Zichuan-ALT/vibration-monitor/evidence/setup_overview.jpg

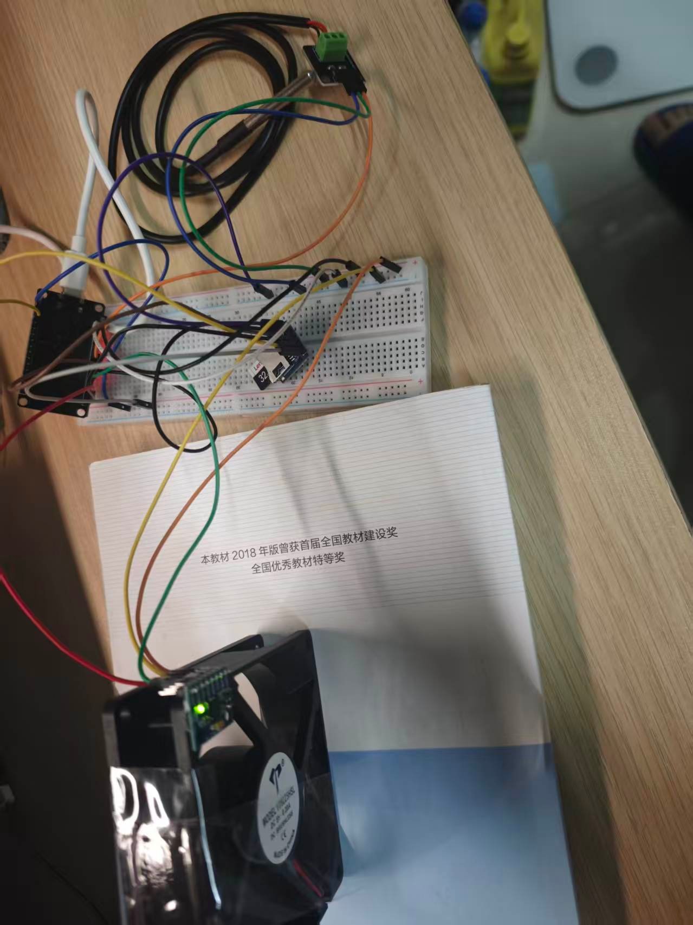
evidence/setup_overview.jpg
