Zichuan-ALT/vibration-monitor/evidence/wiring_breadboard.jpg

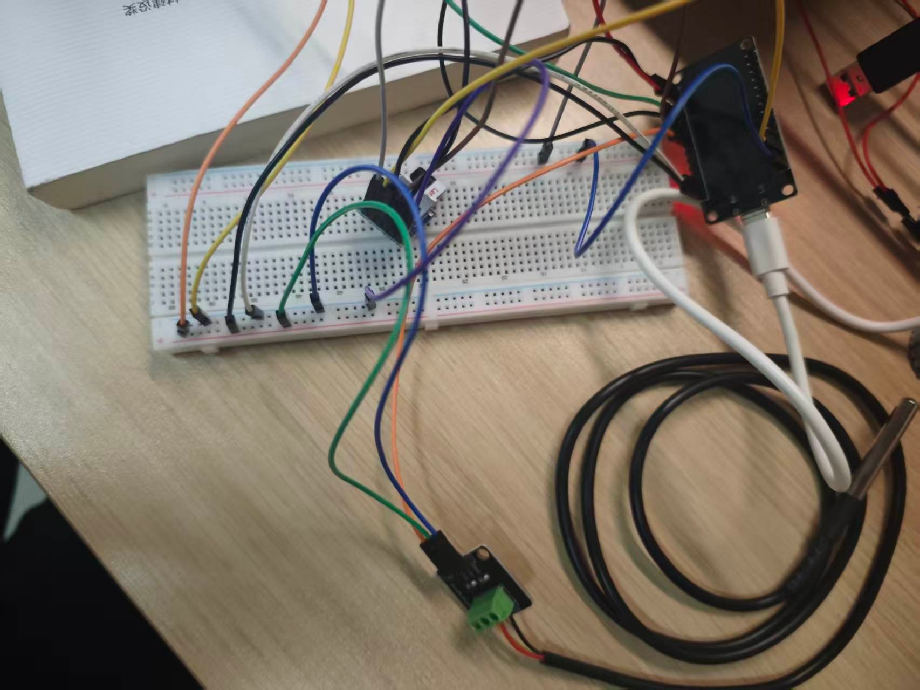
evidence/wiring_breadboard.jpg
