Zichuan-ALT/vibration-monitor/8.1_报告大纲.md

# 8.1 振动状态监测器 —— 工程报告大纲

> 目标篇幅：正文约 28~32 页（不含附录）
> 材料来源均已在仓库中，标注于各节末尾

---

## 1. 引言（约 2 页）

### 1.1 背景与问题
- 旋转机械（风机、水泵、电机）的失效大部分由不平衡、轴承磨损、松动引起
- 传统做法是定期人工巡检或事后维修，成本高、发现晚
- 状态监测（Condition Monitoring）的价值：在故障早期发现征兆

### 1.2 项目目标
- 用低成本器件（≤ ¥150）实现一台可运行、可复现的振动状态监测样机
- 要求：多传感、边缘处理、联网上报、可视化与报警建议

### 1.3 报告结构
- 简述各章内容

---

## 2. 需求分析（约 3 页）

### 2.1 利益相关者与使用场景
- 校园设施运维人员（真实使用者）
- 教学演示（LICHPU 学生）
- 场景：小型风机/水泵的日常状态监测

### 2.2 功能需求（11 条）
- 表格：编号 / 需求 / 优先级（Must / Should / Could）
- **材料**：`8.1_振动状态监测器_项目提案与需求规格说明.docx` 表 5

### 2.3 非功能需求（9 条）
- 重点强调：**成本 ≤ ¥150**、**零焊接**、可用性、可维护性
- **材料**：提案 表 6

### 2.4 验收标准与验证方法（13 条）
- 表格：编号 / 验收标准 / 验证方法 / 实测结果
- **材料**：提案 表 7；实测结果见 `实施方案` 表 27~29

### 2.5 约束与假设
- 单相 220 V 供电、2.4 GHz Wi-Fi、演示用小型风机
- 不涉及高温、高压、防爆场景

---

## 3. 方案设计与选型（约 5 页）

### 3.1 总体架构
- 三层：传感层 → 边缘层 → 服务层
- 架构图（`figures/` 中已有）
- **关键点**：所有特征提取与状态判定都在边缘完成，不上传原始波形

### 3.2 关键设计决策（每个决策都要有"备选方案 → 选择理由"）

| 决策点 | 备选 | 本方案选择 | 理由 |
|---|---|---|---|
| 振动传感器 | 压电式 / ADXL345 / MPU6050 | **MPU6050** | 成本低、I²C 简单、已焊针、±4 g 够用 |
| 温度传感器 | DS18B20 / NTC / 热电偶 | **DS18B20** | 数字输出免标定、单总线、防水探头 |
| 计算位置 | 云端 / 边缘 | **边缘** | 带宽、延迟、隐私、离线可用 |
| 传输协议 | HTTP / MQTT | **MQTT** | 轻量、发布订阅、QoS |
| 存储 | 云数据库 / SQLite | **SQLite** | 零配置、本地、够用 |
| 可视化 | 自研前端 / Node-RED | **Node-RED** | 快速搭建、仪表板开箱即用 |

### 3.3 信号处理设计（**技术核心，要写透**）

**① 采样参数推导**
- 目标分析带宽 → 采样率：关注 10~260 Hz，按 Nyquist 至少 520 Hz，取 **1 kHz** 留余量
- 频率分辨率：Δf = fs/N，取 N=1024 → **Δf = 0.977 Hz**
- 帧长：1024/1000 = **1.024 s**，兼顾实时性与分辨率
- 量程：±4 g（8192 LSB/g），兼顾分辨率与不平衡工况的峰值

**② 为什么必须"带限"计算 RMS**
- 全带 RMS 会把 <10 Hz 的桌面晃动、手持抖动算进去
- 实测对比：全带 RMS 0.05 g vs 带限 RMS 0.005 g（相差 10 倍）
- 实现：由单边幅度谱按 Parseval 定理求 Σ A_k²/2

**③ 特征量选择**
- 带内 RMS：整体振动能量
- 基频带峰值（20~45 Hz）：1× 转频分量，对不平衡最敏感
- 速度有效值（10~250 Hz 积分）：对应 ISO 10816 的评价量

**④ 基线自学习与迟滞判定**
- μ、σ 由 15 帧自学习得到；阈值 = μ+3σ / μ+6σ
- 迟滞：升级 3 帧确认、降级 5 帧确认，避免抖动
- **基线下限保护**：μ < 0.010 g 时拒绝基线（防止停机状态学习）

### 3.4 硬件设计
- 引脚分配表（`实施方案` 表 8）
- 供电：3V3 给传感器、5V 给风扇与 SD 卡
- **零焊接实现**：全部选用已焊针模块 + 面包板 + 杜邦线

### 3.5 软件设计
- 固件流程（启动 → 自学习 → 循环测量 → 缓冲 → 上报）
- Node-RED 流程（MQTT in → 拆分 → 仪表板 / SQLite / 状态映射）
- 数据模型（JSON 字段说明 + SQLite 表结构）

---

## 4. 实现（约 4 页）

### 4.1 硬件搭建
- 13 个搭建步骤的要点（`实施方案` 第 5 章）
- **实际遇到的问题**：模块未焊针、面包板孔被压住、杜邦线松动

### 4.2 固件实现
- 关键代码片段：采样定时、FFT、带限 RMS、环形缓冲、NTP
- **库版本差异**：arduinoFFT 2.x 的模板类与 API 变化

### 4.3 服务端实现
- Node-RED 流程截图
- SQLite 表结构与写入方式（必须用 `prepared`）

### 4.4 仪表板实现
- 实时状态页 / 历史查询页
- 双通道显示（振动 + 表面温度）

### 4.5 成本控制
- 实际支出 ¥119.50 / 预算 ¥150 / 结余 ¥30.50
- **材料**：`实施方案` 表 3~7

---

## 5. 测试与验证（约 5 页）

### 5.1 测试策略
- 单元测试（传感器自检）/ 集成测试（端到端）/ 系统测试（工况实验）

### 5.2 传感器标定与验证

| 项目 | 方法 | 结果 |
|---|---|---|
| MPU6050 真伪 | 读 WHO_AM_I 原始寄存器 | 0x68（原厂） |
| 重力模长 | 静止读取 | 0.991~1.002 g（偏差 0.9%） |
| 噪声底 | 1024 点 × 多帧 | 0.0053 g（带限） |
| DS18B20 稳定性 | 静置 90 s | 噪声 < 1 LSB |
| DS18B20 响应 | 手指捏 30 s | +3.25 ℃，τ≈25~30 s |
| DS18B20 恢复 | 松手 100 s | −4.50 ℃，无迟滞 |

### 5.3 采样与 FFT 验证
- 实测 fs = 999.7 Hz，误差 **−0.03%**（判据 ≤0.5%）
- 谱线锐利无裙边 → 定时与窗函数正确

### 5.4 不平衡工况实验
- 三组：0 / 0.35 / 0.70 g 蓝丁胶配重（单片扇叶、35 mm 半径）
- 结果表 + 频谱对比图
- **材料**：`experiments/2026-10-26-不平衡工况.md`，`experiments/data/spectra_compare.png`

### 5.5 频谱分析
- 1× 33.2 Hz，谐波 3×/4×/7× 同步抬升 → 不平衡的典型特征
- **由 232 Hz 叶片通过频率反推叶片数 = 7**（交叉验证）
- 动态范围约 40 dB

### 5.6 系统联调
- 端到端链路验证
- store-and-forward：断网 30 s，缓冲 5 条，恢复后全部补发
- 补发数据时间戳落在原始测量时刻（NTP 保证）
- **材料**：`experiments/2026-10-26-系统联调.md`

### 5.7 验收标准符合性矩阵
- **13 条 AC 逐条对照实测结果**，这是评估"目标达成"的直接证据

---

## 6. 数据分析与讨论（约 4 页，**最能拉开差距的一章**）

### 6.1 检测灵敏度
- 0.35 g 配重（转子质量 0.4%）→ RMS 上升 25.7 倍
- 结论：方案灵敏度远超需求

### 6.2 亚线性响应与共振
- 配重加倍只带来 1.8 倍增幅（非 2 倍）
- 理论校核：不平衡力 F = m·r·ω²，实测放大 Q≈3.7 → 接近系统共振

### 6.3 **支撑刚度的影响（本项目最有价值的实测发现）**
- 同一台风扇、同一转速，RMS 出现 0.055 g 与 0.207 g（**差 3.7 倍**）
- 判别指标：**基频峰值 / 带内 RMS**
  - 固定良好 ≈ 1.0；风扇晃动 = 0.36
- **认识论层面的教训**：按压传感器时同时给整体结构加阻尼，两个变量混淆，
  导致第一次判断错误；改为按压风扇底座才定位到真因
- 工业含义：传感器无法区分"结构振动"与"刚体运动"，故标准要求刚性基础

### 6.4 温度通道的时间常数与报警设计
- τ ≈ 25~30 s → 温度报警须设分钟级确认延时
- 与振动通道（秒级）的延时策略不同

### 6.5 阈值确定方法
- 固定阈值 vs 基线自学习
- 实测：μ+3σ / μ+6σ 能清晰区分三种工况
- 自学习的脆弱点与保护措施

### 6.6 与设计预期的偏差
| 项目 | 设计预期 | 实测 | 偏差原因 |
|---|---|---|---|
| 噪声底 | 0.0005~0.001 g | 0.0053 g | 估算未计入 DLPF 带宽 |
| 风扇转频 | 1700 RPM | 2050~2120 RPM | 铭牌不准 |
| 基频带 | 15~35 Hz | 需放宽到 20~45 Hz | 实测转速超出 |

### 6.7 局限性
- 单一测点、单轴（虽三轴但取最强）
- 无转速传感器，靠频谱推断
- 未做长时间误报率统计
- 演示用小型风机对配重过于敏感，与工业机组可比性有限

---

## 7. 专业实践（约 2 页）

### 7.1 版本控制
- Git 仓库 70 个文件、15+ 次提交、语义化提交信息
- 仓库地址：https://github.com/Zichuan-ALT/vibration-monitor

### 7.2 风险管理
- 13 项风险登记册（提案 表 11）
- **实际发生的风险**：模块未焊针、网络屏蔽 GitHub、传感器松动

### 7.3 受控文档
- 台账 9 张表：需求追踪、BOM、测试记录、工况记录、问题日志、变更记录、会议记录、风险登记、交付清单

### 7.4 调试记录（体现工程能力）
三个典型问题的排查过程：
1. `Bad data inject` → 读源码定位 payload 结构要求
2. 历史图空白 → 对比同项目正常节点，发现 `removeOlder = 0` 陷阱
3. 振动读数异常偏高 → 排除法定位到支撑刚度

### 7.5 标准与规范
- ISO 10816（振动烈度评价）
- DS18B20 / MPU6050 数据手册
- MQTT 3.1.1

---

## 8. 负责任的设计（约 2 页）

### 8.1 安全
- 电气：3.3 V 逻辑、USB 供电、无市电裸露
- 机械：风扇固定、配重防甩飞（离心力计算）
- 数据：本地存储、不上传原始波形

### 8.2 隐私
- 仅采集设备振动与温度，不涉及人员信息
- 无摄像头、无音频

### 8.3 可持续性
- 成本 ¥119.50，可批量部署
- 低功耗（ESP32 + 传感器约 0.5 W）
- 模块化设计，损坏可单独更换

### 8.4 可维护性
- 串口命令 `r` 重学基线、`b` 查状态
- 阈值自适应，无需人工设定
- 断网可用（store-and-forward）

### 8.5 伦理与社会影响
- 正面：减少非计划停机、延长设备寿命
- 风险：过度依赖自动化报警、需保留人工判断

---

## 9. UL–LICHPU 复制与推广（约 1 页）

### 9.1 环境差异
| 项目 | UL（爱尔兰） | LICHPU（中国） |
|---|---|---|
| 供电 | 230 V / 50 Hz | 220 V / 50 Hz |
| 网络 | 校园 Wi-Fi（802.1X） | 热点/有线 |
| 采购 | 欧盟渠道 | 国内电商 |

### 9.2 复制需要做的适配
- 电源插头与电压（本方案用 USB 5 V，天然兼容）
- Wi-Fi 认证方式（需改为企业级认证或热点）
- 元器件替代（同型号国内可得）

### 9.3 价值
- 教学：低成本、可拆解、现象直观
- 运维：可作为校园设施的轻量监测节点

---

## 10. 结论与后续工作（约 1.5 页）

### 10.1 完成情况
- 对照 13 条验收标准，全部达成
- 可运行样机、双通道数据、完整链路

### 10.2 主要贡献
1. 在 ¥150 预算内实现完整状态监测链路
2. 实测量化了支撑刚度对测量的影响（3.7 倍）
3. 建立了可复现的实验方法与证据链

### 10.3 后续改进
- 加转速传感器，实现阶次分析
- 多测点、多设备组网
- 引入机器学习做故障分类
- 长时间运行统计误报率

---

## 附录

| 附录 | 内容 | 来源 |
|---|---|---|
| A | 硬件清单与实际成本 | 实施方案 表 3~7 |
| B | 引脚分配表 | 实施方案 表 8 |
| C | 固件关键参数表 | 实施方案 表 23 |
| D | 关键代码清单 | `firmware/` |
| E | 实验原始数据 | `experiments/` |
| F | 仪表板与频谱截图 | `evidence/`、`experiments/data/` |
| G | 团队分工与个人贡献 | 待补 |
| H | 参考文献 | 待补 |

---

## 写作建议

### 优先级（若时间紧）
1. **第 5、6 章**（测试与数据分析，占 20%，且我们素材最全）
2. **第 3 章**（技术设计，占 25%）
3. 第 2、7、8 章（可从已有文档摘取）
4. 第 1、9、10 章（最后写，收尾性质）

### 写作顺序建议
```
先写第 5 章（有数据，最好写）
→ 再写第 6 章（基于第 5 章的分析）
→ 再写第 3 章（技术设计，需回头对照）
→ 最后补 1/2/7/8/9/10 章
→ 摘要最后写
```

### 可以直接复用的内容
- 第 2 章 ← 提案（17 页）几乎可直接摘
- 第 3、4 章 ← 实施方案（25 页）改写
- 第 5 章 ← 3 份实验记录组装
- 第 7 章 ← 台账

### 图表清单（需要在报告中出现的）
| 图号 | 内容 | 文件 |
|---|---|---|
| 图 1 | 系统架构图 | `figures/` |
| 图 2 | 硬件接线图 | 实施方案 图 8 |
| 图 3 | 固件流程图 | 实施方案 |
| 图 4 | 三工况频谱对比 | `experiments/data/spectra_compare.png` |
| 图 5 | 仪表板-正常 | `evidence/dashboard_live_normal.png` |
| 图 6 | 仪表板-报警 | `evidence/dashboard_live_alarm.png` |
| 图 7 | 仪表板-双通道 | `evidence/dashboard_dual_sensor.png` |
| 图 8 | 历史曲线 | `experiments/data/history_from_db.png` |
| 图 9 | 温度响应曲线 | 由实验记录数据重绘 |
