Zichuan-ALT/vibration-monitor/evidence/dashboard_alarm.png

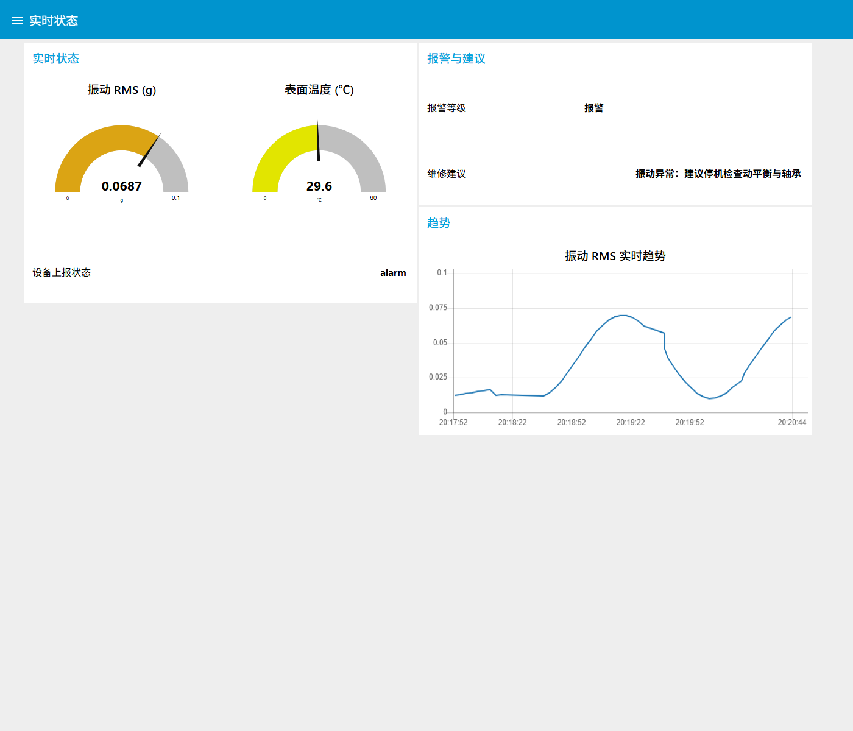
evidence/dashboard_alarm.png
