Zichuan-ALT/vibration-monitor/evidence/dashboard_dual_sensor.png

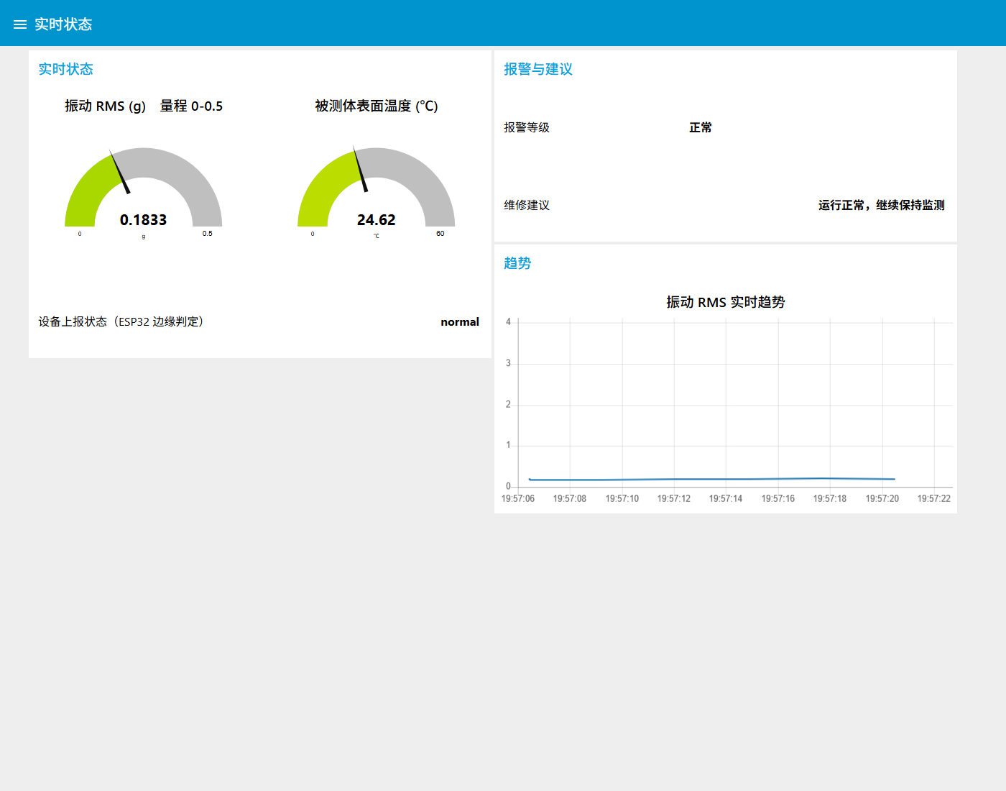
evidence/dashboard_dual_sensor.png
