Zichuan-ALT/vibration-monitor/evidence/dashboard_live_v1.png

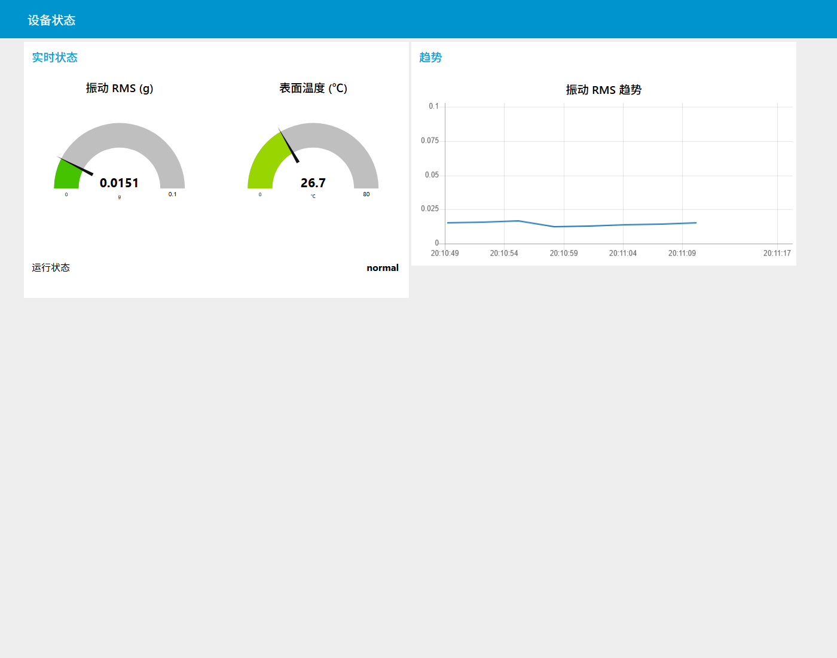
evidence/dashboard_live_v1.png
