Zichuan-ALT/vibration-monitor/evidence/dashboard_live_v2.png

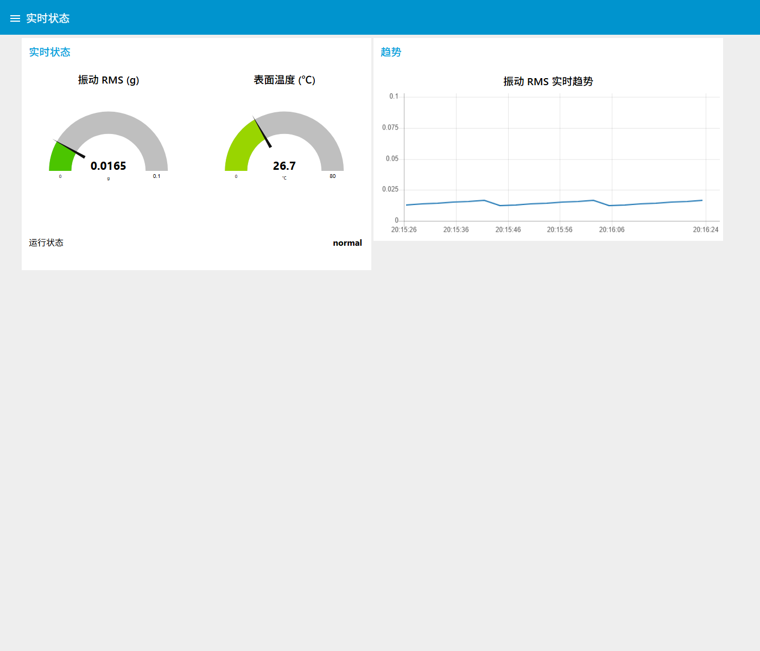
evidence/dashboard_live_v2.png
