Zichuan-ALT/vibration-monitor/evidence/device_with_dashboard.jpg

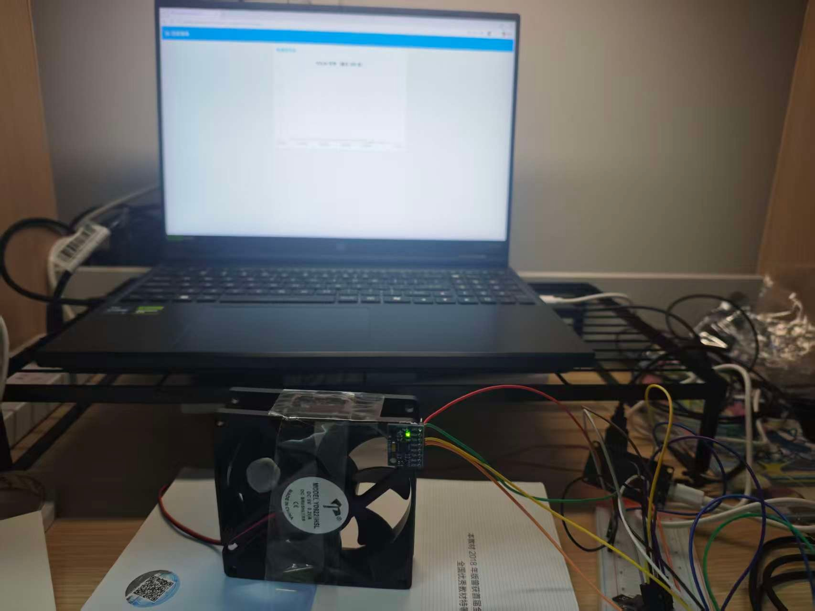
evidence/device_with_dashboard.jpg
