Zichuan-ALT/vibration-monitor/experiments/data/spectrum_工况1-基准_0g_.png

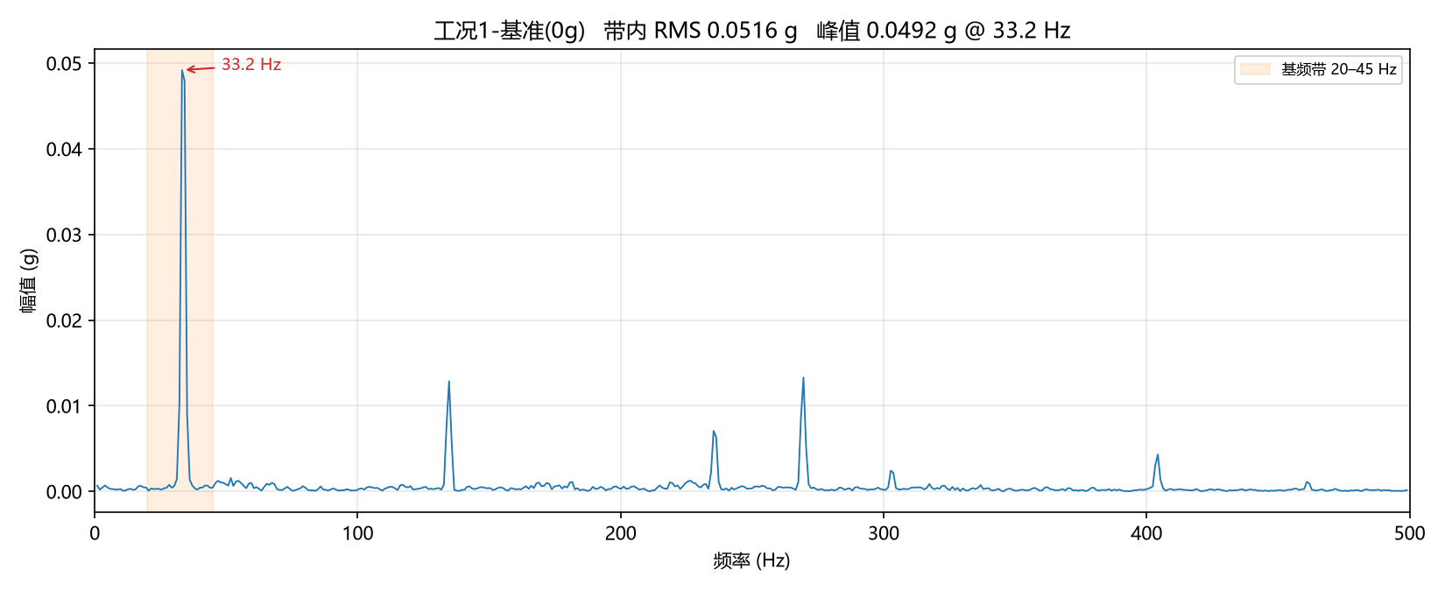
experiments/data/spectrum_工况1-基准_0g_.png
