Zichuan-ALT/vibration-monitor/experiments/data/spectrum_工况2-轻微不平衡_0_35g_.png

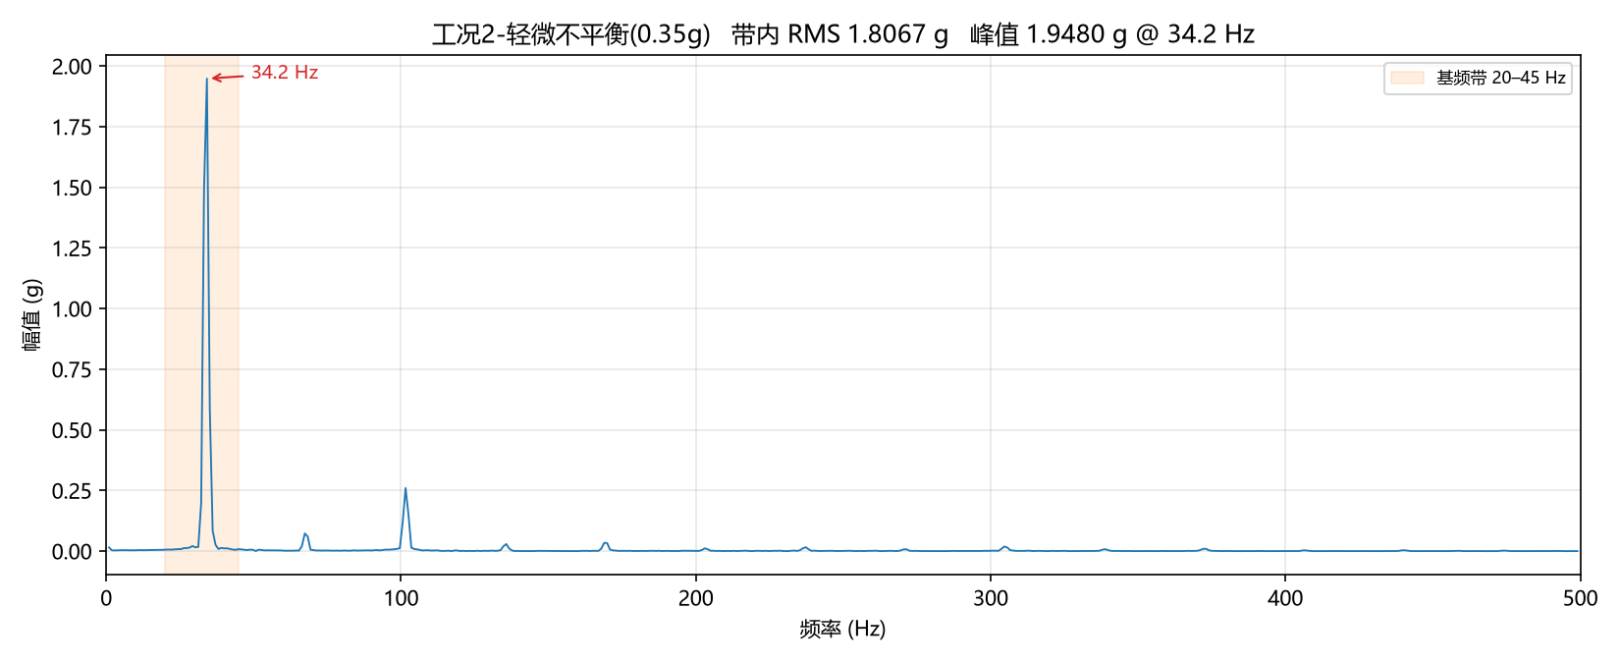
experiments/data/spectrum_工况2-轻微不平衡_0_35g_.png
