Zichuan-ALT/vibration-monitor/experiments/data/spectrum_工况3-明显不平衡_0_70g_.png

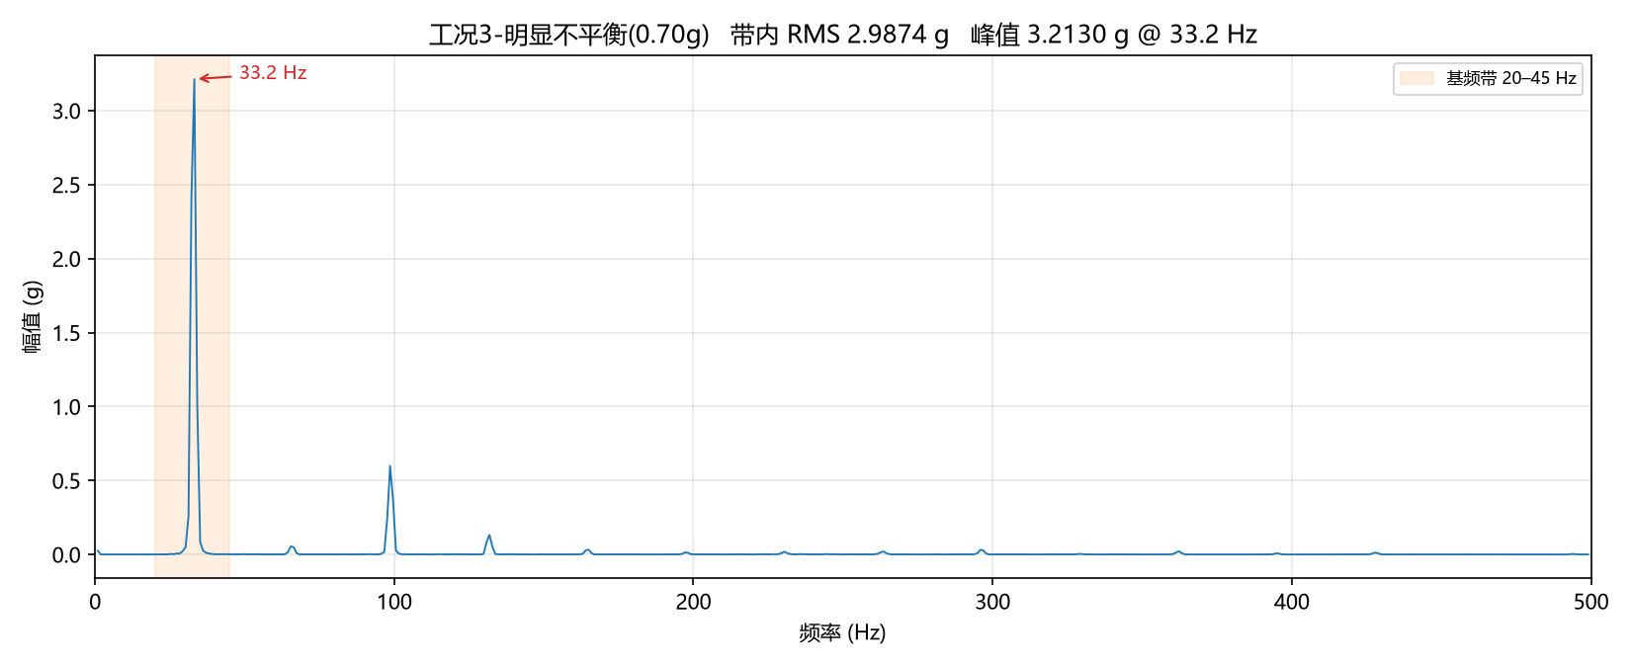
experiments/data/spectrum_工况3-明显不平衡_0_70g_.png
