Zichuan-ALT/vibration-monitor/8.1_受控文档台账.xlsx

Sheet: 0-文档控制
项目 8.1 振动状态监测器 · 受控文档台账
利莫瑞克大学 × LICHPU 工业评估（15 ECTS）· 智慧校园生活实验室 · 主题 8 智能设施与预测性维护
文件名 | 8.1_受控文档台账.xlsx
版本 | V3.2
更新日期 | 2026-10-29
技术路线 | ESP32-WROOM-32 单板 + MPU6050（I²C，加速度 + 板载温度）+ DS18B20 表面温度 + Node-RED 仪表板
装配方式 | 模块均为带排针的成品板，杜邦线直插；裸线经螺丝端子转接，无需额外加工
对应关口 | 第 2 周 需求关口 / 第 3 周 设计关口 / 第 6 周 中期评估
关联主文档 | 8.1_振动状态监测器_项目提案与需求规格说明.docx（提案与需求，评估组成 A） 8.1_振动状态监测器_实施方案.docx（施工、调试与验证手册）
维护责任人 | P1 项目/客户协调员（风险登记册与计划）；P4 测试/验证（测试记录）
变更规则 | 任一工作表的字段增删须在“8-变更记录”中登记，并由 P1 更新版本号
评审节奏 | 每周例会复核一次；关口前 2 天冻结并导出 PDF 归档
成本口径 | 物料清单按「参考价 / 实际采购价」双列登记，实际采购支出合计 ¥119.50，详见「2-物料与耗材清单」
工作表一览
1-需求与验收 | 11 项功能性需求、9 项非功能性需求、13 条验收标准及追溯关系
2-物料与耗材清单 | 13 项物料，含分类小计与实际支出合计（公式自动计算）
3-风险登记册 | 12 项风险，等级由概率 × 影响自动计算
4-责任矩阵 | 9 项交付物 × 4 个角色的 R/S/C/I 分工
5-十二周计划 | 任务、周次、责任人、交付物与正式关口
6-测试记录 | 测试执行记录模板（对应评估组成 D）
7-工况实验记录 | 工况变化对照实验的数据记录模板
8-变更记录 | 受控文档的版本变更登记

Sheet: 1-需求与验收
需求与验收标准（含追溯关系）
项目 8.1 振动状态监测器 · 受控文档台账 | 版本 V3.2 | 更新日期 2026-10-29 | 维护人：P1
编号 | 类别 | 需求 / 判据描述 | 优先级 | 追溯对象 | 验证方法 | 证据周次
FR-01 | 功能 | 采集振动（I²C，1 kSPS，帧长 1024 点）与两路温度，共三路数据 | M | AC-01 / AC-04 | 单元 + 集成 | 第 4 周
FR-02 | 功能 | 计算时域特征：RMS、峰值、速度有效值（10 ~ 250 Hz 积分） | M | AC-03 | 单元 | 第 5 周
FR-03 | 功能 | 完成 1024 点 FFT，给出主频与基频带（15 ~ 35 Hz）内峰值 | M | AC-02 | 单元 | 第 5 周
FR-04 | 功能 | 支持开机基线自学习，并给出相对基线的偏离度 | M | AC-05 / AC-06 | 系统 | 第 6 周
FR-05 | 功能 | 输出“正常 / 注意 / 报警”三级状态与维护建议 | M | AC-05 / AC-06 | 系统 + 验证实验 | 第 8 周
FR-06 | 功能 | 通过 MQTT 上报特征值，周期 ≤ 10 s，事件即时上报 | M | AC-07 | 集成 | 第 6 周
FR-07 | 功能 | 断网时本地缓存，网络恢复后补传，不丢数据 | S | AC-09 | 系统 | 第 10 周
FR-08 | 功能 | 提供中英双语仪表板，含实时值、历史趋势与频谱 | M | AC-10 | 用户评估 | 第 6 周
FR-09 | 功能 | 提供本地指示（板载 LED + 蜂鸣器），无网络时仍可判读 | S | AC-09 | 系统 | 第 10 周
FR-10 | 功能 | 记录报警事件（含触发指标与时间戳）并可导出 | S | AC-10 | 系统 | 第 9 周
FR-11 | 功能 | 支持板载按键重新学习基线与静音 | C | — | 现场操作 | 第 10 周
NFR-01 | 非功能 | 全部电路 ≤ 5 V 直流（USB 供电），不接触市电；转动部件加防护 | M | — | 走查 | 第 3 周
NFR-02 | 非功能 | 不使用摄像头或麦克风，不采集任何可识别个人的数据 | M | — | 走查 | 第 3 周
NFR-03 | 非功能 | 连续运行 ≥ 72 h 无重启；看门狗、掉电恢复、断网自愈 | M | AC-08 | 系统 | 第 10 周
NFR-04 | 非功能 | 模块可现场插拔更换且免重新编译；基线可一键重学 | S | — | 走查 | 第 10 周
NFR-05 | 非功能 | 单节点成本 ≤ ¥150（含耗材与备件） | M | AC-11 | 核算 | 第 3 周
NFR-06 | 非功能 | 仪表板中英双语；状态用文字 + 图标 + 颜色三重编码；字号可调 | M | — | 用户评估 | 第 6 周
NFR-07 | 非功能 | 数据模型带版本号并有文档，可被第三方平台订阅复用 | S | — | 走查 | 第 9 周
NFR-08 | 非功能 | 全程使用杜邦线与螺丝端子转接 | M | AC-13 | 走查 | 第 3 周
NFR-09 | 非功能 | 外壳防护 ≥ IP54，工作温度 0 ~ 50 ℃ | S | — | 走查 | 第 10 周
AC-01 | 验收 | 振动采样率误差 ≤ 0.5 % | — | FR-01 | 连续采集 1 s 统计实际点数（1000 ± 5） | 第 4 周
AC-02 | 验收 | 频谱频率误差 ≤ 1 % 或 ≤ Δf | — | FR-03 | 音箱振膜 + 100 Hz 正弦验证 | 第 5 周
AC-03 | 验收 | 幅值相对偏差 ≤ 10 % | — | FR-02 | 与手持测振仪同点同时比对 | 第 7 周
AC-04 | 验收 | 温度测量准确度 ± 0.5 ℃ | — | FR-01 | 冰水浴与温水比对 | 第 5 周
AC-05 | 验收 | 3 类工况变化中至少 2 类在 60 s 内检出并分级正确 | — | FR-05 | 不平衡 / 松动 / 负载变化对照实验 | 第 8 周
AC-06 | 验收 | 正常工况 2 h 内假阳性 ≤ 1 次 | — | FR-04 | 正常工况长时运行 | 第 8 周
AC-07 | 验收 | 报警端到端延迟 ≤ 5 s | — | FR-06 | 注入越限信号并计时 | 第 8 周
AC-08 | 验收 | 连续运行 ≥ 72 h 无重启，丢数率 ≤ 1 % | — | NFR-03 | 不间断运行并统计记录条数 | 第 10 周
AC-09 | 验收 | 断网 ≤ 30 s 内自动重连并补传 | — | FR-07 / FR-09 | 拔插网线测试 | 第 10 周
AC-10 | 验收 | 仪表板刷新 ≤ 5 s；历史可查 ≥ 4 周 | — | FR-08 / FR-10 | 走查 + 数据库查询 | 第 9 周
AC-11 | 验收 | 单节点成本 ≤ ¥150 | — | NFR-05 | 按物料清单核算（本版 ¥94 / ¥119） | 第 3 周
AC-12 | 验收 | 重复性：变异系数 ≤ 3 % | — | FR-02 / FR-03 | 同一工况重复测量 10 次 | 第 8 周
AC-13 | 验收 | 装配方式：全部连接为插拔式或螺丝端子 | — | NFR-08 | 装配过程走查与记录 | 第 3 周
优先级：M 必须 / S 应该 / C 可以。验收标准均须附测量记录，证据归档到 Git 仓库 /evidence 目录。

Sheet: 2-物料与耗材清单
物料与耗材清单（参考价 / 实际采购价对照）
项目 8.1 振动状态监测器 · 受控文档台账 | 版本 V3.2 | 更新日期 2026-10-29 | 维护人：P1
# | 类别 | 物料 / 规格 | 数量 | 参考单价 ¥ | 实际单价 ¥ | 实际小计 ¥ | 采购备注
1 | 主要器件 | ESP32-WROOM-32 开发板（CH340C，带排针 30Pin，Type-C） | 2 | 25 | 23 |  | 含备件；淘宝
2 | 主要器件 | MPU-6050 三轴重力加速度模块（GY-521，带排针，I²C） | 1 | 6 | 13.5 |  | 到货读 WHO_AM_I 应为 0x68
3 | 主要器件 | DS18B20 带防水探头转接模块 + 传感器 + 杜邦线 | 1 | 8 | 8.5 |  | 模块自带绿色端子
4 | 主要器件 | Micro SD 卡模块 SPI 接口（带排针，带电平转换） | 1 | 5 | 2.3 |  | VCC 先试 3.3 V，不行再 5 V
5 | 主要器件 | microSD 32 GB Class10 A1（联想，全新带 5 年换新） | 1 | 15 | 35.9 |  | 不用二手卡；到手拷 4 GB 验容量
6 | 主要器件 | 有源蜂鸣器模块（3.3~5 V，低电平触发） | 1 | 2 | 1.5 |  | 低电平触发：GPIO25 输出 LOW 时响；上电前先拉高，见实施方案 5.3 ⑤
7 | 主要器件 | 静音风扇 5 V 9225（92 mm，1700 RPM，XH2.54-2P） | 1 | 12 | 4.8 |  | 转频 28.3 Hz，落在基频带内
8 | 连接件 | TYPE-C 数据线 1 m（可传输数据） | 1 | 5 | 2.2 |  | 非纯充电线
9 | 连接件 | USB 公头转杜邦 2.54 mm 线（给风扇供 5 V） | 1 | 5 | 4.8
10 | 连接件 | 杜邦线 母-母 / 母-公 20 cm | 1 | 6 | 0 |  | 学校提供
11 | 连接件 | 面包板 400 孔（电源轨分配） | 1 | 5 | 0 |  | 学校 / 自有
12 | 结构电源 | 外壳 / 底板 / 配重（快递盒 + 木条 + 硬币） | 1 | 13 | 0 |  | 自备
13 | 结构电源 | USB 充电器 ×2（ESP32 与风扇各一） | 2 | 0 | 0 |  | 现有
 |  | 实际支出合计
 |  | 按参考单价口径合计（对照）
 |  | 说明：实际单价为最终采购价（含税、含运费）；参考单价为方案编制时的估价。杜邦线与面包板由学校提供、外壳与底板自备、电源用现有 USB 充电器，故实际支出为 0。服务端复用现有笔记本，不产生硬件采购。详见「1-需求与验收」。

Sheet: 3-风险登记册
风险登记册（等级 = 概率 × 影响，自动计算）
项目 8.1 振动状态监测器 · 受控文档台账 | 版本 V3.2 | 更新日期 2026-10-29 | 维护人：P1
ID | 风险描述 | 类别 | 概率 P | 影响 I | 等级 | 应对措施 | 责任人 | 触发条件 | 状态
R-01 | 传感器安装方式不当导致高频幅值失真 | 技术 | 2 | 2 |  | 模块贴紧外壳刚性安装，标定记录安装方式并做频响修正 | P2 | 不同安装方式下幅值差异 > 10 % | 开放
R-02 | 无标准振动台，幅值无法绝对溯源 | 资源 | 3 | 2 |  | 重力翻转静态标定 + 手持测振仪比对 + 报告不确定度 | P4 | 第 7 周仍无可用比对设备 | 开放
R-03 | Wi-Fi 覆盖不足或丢包 | 基础设施 | 2 | 2 |  | 本地 SD 先存后传；必要时用手机热点 | P3 | 连续丢包 > 1 % | 开放
R-04 | MPU6050 带宽仅 260 Hz，限制可诊断的故障类型 | 技术 | 3 | 3 |  | 确认目标故障频率均 < 130 Hz 并写入报告；预留升级到 ICM-42688-P 的路径 | P3 | 出现 > 260 Hz 的诊断需求 | 开放
R-05 | 台架转速过低，基频带内无可观测峰值 | 技术 | 2 | 2 |  | 选用 1200 r/min 以上风扇；必要时下移基频带并重新标定 | P2 | 基频峰值 < 15 Hz | 开放
R-06 | 到货与预期不符（排针未焊、随附线缆为纯充电线） | 采购 | 3 | 2 |  | 下单明确勾选“带排针”版本；到货当天验货，不合格立即换货；另备一根数据线 | P2 | 到货为散件或线缆不可传数据 | 开放
R-07 | 采样节拍被 Wi-Fi 中断，频谱失真 | 技术 | 3 | 2 |  | 采样任务绑定 core 1 并设高优先级；采样用定时器而非 delay | P3 | 采样点数偏差 > 0.5 % | 开放
R-08 | MQTT 报文超长导致静默发送失败 | 技术 | 3 | 2 |  | 首行设置 setBufferSize(1024)；增加发送返回值检查 | P3 | MQTTX 收不到完整 JSON | 开放
R-09 | 器件缺货或交期过长 | 采购 | 2 | 3 |  | 提前 2 周下单；ESP32 与 MPU6050 各备一件 | P2 | 交期 > 10 天 | 开放
R-10 | 团队时间冲突（其他模块考核） | 项目 | 3 | 2 |  | 周会 + WBS 分解到人；关键路径任务提前一周启动 | P1 | 连续两周进度延期 | 开放
R-11 | microSD 卡损坏导致历史丢失 | 技术 | 2 | 2 |  | 使用 Class10 卡；每日校验落盘；重要数据每周导出到仓库 | P3 | 文件写入校验失败 | 开放
R-12 | Node-RED 或笔记本不可用 | 基础设施 | 2 | 2 |  | 节点本地闭环运行；恢复后补传 | P3 | 服务端掉线 > 30 min | 开放
R-13 | 校准不确定度导致结论不可靠 | 验证 | 2 | 2 |  | 给出不确定度估算，结论附置信区间，避免过度断言 | P4 | 同点重测偏差 > 10 % | 开放
概率 / 影响取值为 1（低）、2（中）、3（高）。等级 ≥ 6 的风险需在周会上专项跟踪。

Sheet: 4-责任矩阵
责任矩阵（R 主责 / S 支持 / C 审核 / I 知会）
项目 8.1 振动状态监测器 · 受控文档台账 | 版本 V3.2 | 更新日期 2026-10-29 | 维护人：P1
交付物 | P1 项目/客户协调员 | P2 硬件/集成 | P3 软件/数据 | P4 测试/文档
问题定义与需求规格 | R | S | S | C
系统设计与选型 | C | R | S | S
硬件搭建与台架 | I | R | S | S
固件与边缘算法 | I | S | R | C
通信与仪表板 | I | S | R | S
校准与测试计划 | C | S | S | R
验证实验执行与数据分析 | S | S | C | R
风险登记册与项目记录 | R | S | S | C
报告、演示与个人日志 | C | S | S | R
每位成员须同时具备一项主责（R）。中期评审时更新并随报告提交。

Sheet: 5-十二周计划
十二周计划与正式关口
项目 8.1 振动状态监测器 · 受控文档台账 | 版本 V3.2 | 更新日期 2026-10-29 | 维护人：P1
# | 任务 | 周次 | 责任人 | 交付物 | 关口
1 | 问题定义与校园需求（客户访谈） | 1 | P1 | 问题陈述、利益相关者、地点、成功标准 | 概念评审
2 | 现状对标 · 需求与验收标准 · 伦理/隐私/安全筛查 | 2 | P1/P4 | 对标分析、11 项 FR、9 项 NFR、13 条 AC、筛查表 | 需求关口
3 | 系统设计：架构、选型、物料清单、风险登记册；下单采购 | 3 | P2/P3 | 架构图、物料清单、风险登记册 | 设计关口
4 | 步骤 1~4：最小系统、MPU6050、DS18B20、microSD（接线方式同前） | 4 | P2 | 可运行硬件，单元测试记录 | 进度评审 1
5 | 步骤 5~6：定时采样与 FFT、特征计算 | 5 | P3 | 固件与频谱验证记录 | —
6 | 步骤 7~9：基线判别、MQTT 上报、Node-RED 仪表板 | 6 | P3/P4 | 可演示的端到端系统 | 中期评估
7 | 步骤 10：校准（重力翻转、温度、幅值比对） | 7 | P4 | 校准报告与不确定度 | 技术评审
8 | 步骤 11~12：台架搭建与三类工况对照实验 | 8 | P4/P2 | 实验数据集 | 证据检查点
9 | 数据分析、SDG 与部署评估、UL–LICHPU 复制性 | 9 | P4/P1 | 分析报告、复制性评估 | 进度评审 2
10 | 缺陷修复、设计冻结、连续 72 h 运行验证 | 10 | 全员 | 缺陷关闭清单、AC-08 记录 | 设计冻结
11 | 报告、海报、演示准备、仓库与文档收尾 | 11 | 全员 | 报告草稿、幻灯片、README | 草案就绪
12 | 最终评估：原型演示 + 团队汇报 + 个人答辩 | 12 | 全员 | 原型、报告、个人工程日志 | 最终关口
周次与《实施方案》第四章的 13 个施工步骤对应；关口日期待模块负责人确认后填入。

Sheet: 6-测试记录
测试执行记录（对应评估组成 D，全部为实测结果）
项目 8.1 振动状态监测器 · 受控文档台账 | 版本 V3.2 | 更新日期 2026-10-29 | 维护人：P1
用例 ID | 关联需求 | 测试层级 | 测试日期 | 执行人 | 输入 / 条件 | 期望结果 | 实测结果 | 判定 | 证据文件
TC-001 | FR-01 | 单元 | 2026-10-25 | P3 | 连续采集 1024 点，用 micros() 记录实际耗时 | 采样率误差 ≤ 0.5 % | 耗时 1023 ms，得 999.7 Hz，误差 −0.03 % | P | firmware/07_sampling_fft
TC-002 | FR-01 | 单元 | 2026-10-25 | P3 | 直读 0x75 寄存器原始值 | WHO_AM_I = 0x68 | 原始值 0x68（库归一化后返回 0x34，已核对两者） | P | firmware/06_mpu6050_test
TC-003 | FR-01 | 单元 | 2026-10-25 | P3 | 静止平放，读取三轴合成模长 | 1.000 ± 0.2 g | 0.991 ~ 1.002 g（偏差 0.9 %） | P | firmware/06_mpu6050_test
TC-004 | FR-02 | 单元 | 2026-10-25 | P3 | 模块静置，1024 点 × 多帧，取带限 RMS | 与噪声密度推算同量级 | 0.0053 g（手册推算约 0.0064 g） | P | experiments/2026-10-25
TC-005 | FR-02 | 系统 | 2026-10-26 | P4 | 风扇正常运转，读取基频带峰值频率 | 位于 1× 转频 ± 2 Hz | 稳定在 33 ~ 35 Hz（对应 1990 ~ 2110 RPM） | P | experiments/data/spectrum_*.csv
TC-006 | FR-03 | 单元 | 2026-10-27 | P3 | 读取 OneWire ROM 地址 | 家族码 0x28（DS18B20） | 28:9C:52:23:7D:25:0B:DD | P | firmware/10_ds18b20_test
TC-007 | FR-03 | 单元 | 2026-10-27 | P3 | 静置 90 s，连续读数 53 次 | 噪声低于 1 LSB | 极差 0.25 ℃，读数成段恒定，台阶恰为 0.0625 ℃ | P | experiments/2026-10-27
TC-008 | FR-03 | 单元 | 2026-10-27 | P3 | 手指握持探头 30 s | 升温明显且可观察 | 升温 3.25 ℃（30.19 → 33.44），速率单调递减 | P | experiments/2026-10-27
TC-009 | FR-03 | 单元 | 2026-10-27 | P3 | 松开探头后静置 100 s | 温度回落且无迟滞 | 降温 4.50 ℃（32.62 → 28.12），平滑指数衰减 | P | experiments/2026-10-27
TC-010 | FR-05 | 集成 | 2026-10-26 | P3 | 设备发布一帧完整 JSON | 字段齐全、时间戳正确 | 收到报文，ts 为 NTP 时间且逐条递增 | P | .node-red/mqtt_received.log
TC-011 | FR-09 | 系统 | 2026-10-26 | P3 | 断开笔记本 Wi-Fi 30 s 后恢复 | 自动重连、补发且不丢数据 | 缓冲 1→5 条，恢复后全部补发；补发数据时间戳仍为原测量时刻 | P | experiments/2026-10-26-系统联调.md
TC-012 | FR-10 | 集成 | 2026-10-26 | P3 | 连续运行，检查 SD 卡日志文件 | 每帧一行且可读回 | /vib_log.csv 正常追加，每行 flush，掉电最多丢 1 条 | P | firmware/09（串口命令 l）
TC-013 | FR-04 | 系统 | 2026-10-26 | P4 | 风扇运转中现场加入 0.35 g 配重 | 10 s 内状态升为报警 | 约 6 s 后状态由 normal 翻转为 alarm | P | evidence/dashboard_live_alarm.png
TC-014 | NFR-05 | 单元 | 2026-10-27 | P3 | 风扇停转时触发基线自学习 | 应拒绝该基线 | μ = 0.0053 g < 0.010 g，拒绝并置为 uncalibrated | P | 串口日志
TC-015 | FR-06/07 | 系统 | 2026-10-26 | P4 | 仪表板查看实时状态与历史查询 | 显示值与数据库记录一致 | 累计 2346 条记录，曲线与库内数据一致 | P | evidence/dashboard_*.png
判定列用 P（通过）/ F（失败）。本表 15 条用例全部通过；失败与遗留问题记录在 experiments/ 下的实验文档中。

Sheet: 7-工况实验记录
工况变化对照实验记录（全部为实测结果）
项目 8.1 振动状态监测器 · 受控文档台账 | 版本 V3.2 | 更新日期 2026-10-29 | 维护人：P1
试验编号 | 工况 | 施加参数 | 转频 Hz | 1× 峰值 g | 振动 RMS g | 表面温度 ℃ | 芯片温度 ℃ | 系统判定 | 备注 / 数据文件
EXP-001 | 正常基线 | 无配重，风扇正常运转 | 32.2 | 0.0292 | 0.0574 | 24.05 | 25.6 | 正常 | 基线 μ=0.0574 g；experiments/2026-10-26
EXP-002 | 转子不平衡 | 配重 0.35 g（单片扇叶，r ≈ 35 mm） | 33.2 | 1.6605 | 1.4723 | 24.05 | 25.7 | 报警 | RMS 上升 25.7 倍；谐波同步抬升
EXP-003 | 转子不平衡 | 配重 0.70 g（同上位置） | 31.2 | 2.8015 | 2.6816 | 24.05 | 25.7 | 报警 | RMS 上升 46.7 倍；接近 ±4 g 量程上限
EXP-004 | 风道堵塞 | 遮挡进风面 50 %，稳定 5 min | 34.2 | 0.0487 | 0.0589 | 24.67 | — | 正常 | 温度 +0.62 ℃、RMS −32 %（特征反向）
EXP-005 | 风道堵塞 | 遮挡进风面 80 %，稳定 5 min | 31.5 | 0.0242 | 0.0605 | 24.85 | — | 正常 | 温度 +0.80 ℃、1× 峰值 −69 %、转频 −8.7 %
EXP-006 | 支撑松动 | 风扇自由放置于桌面（未固定） | 35.2 | 0.079 | 0.2068 | — | — | 正常 | 峰值/RMS=0.38，数据不可信；experiments/2026-10-27
EXP-007 | 支撑恢复 | 按压/固定风扇底座后复测 | 35.2 | 0.047 | 0.0556 | — | — | 正常 | 峰值/RMS=0.85，恢复到历史稳定水平
所有工况均在「同一次装配内连续完成」，避免跨会话的耦合状态变化。结论：转子不平衡的特征是振动大幅上升、温度基本不变；风道堵塞的特征是温度上升而振动下降，两者方向相反，故需双通道才能区分。

Sheet: 8-变更记录
受控文档变更记录
项目 8.1 振动状态监测器 · 受控文档台账 | 版本 V3.2 | 更新日期 2026-10-29 | 维护人：P1
版本 | 日期 | 变更人 | 变更类型 | 变更说明与影响范围
V1.0 | 2026-10-29 | P1 | 首次发布 | 建立需求与验收、物料清单、风险登记册、责任矩阵、十二周计划与测试记录模板
V1.1 | 2026-10-29 | P1 | 设计变更 | 新增 ESP32 单板方案的物料清单与需求变更清单
V2.0 | 2026-10-29 | P1 | 设计变更 | 全面改为 ESP32 单板方案：11 项 FR / 8 项 NFR / 12 条 AC；物料 25 项含耗材（¥211）
V3.2 | 2026-10-29 | P1 | 采购定稿（最终清单） | 物料清单更新为最终采购清单：ESP32 ¥23×2、MPU6050 ¥13.5、DS18B20 ¥8.5、SD 卡座 ¥2.3、联想 32G 卡 ¥35.9、蜂鸣器 ¥1.5、5V 9225 风扇 ¥4.8、数据线 ¥2.2、USB 转杜邦线 ¥4.8；杜邦线与面包板由学校提供。取消 12 V 升压线与 KF301 端子。实际支出 ¥119.50
V3.1 | 2026-10-29 | P1 | 采购落实（台账保持更新） | 物料清单改为“参考价 / 实际价”双列并登记真实采购价与商家备注；确认面包板与母-公杜邦线为自有、外壳与配重自备；删除 KF301 端子（DS18B20 自带端子、风扇用升压线直插、电源分配用面包板）；成本口径由“估价值”更新为“实际采购价 ¥119.50”
V3.0 | 2026-10-29 | P1 | 设计冻结（响应工艺与供应约束） | 以提高集成度、减少外接元件为目标重构：① 振动传感器由 ADXL345（SPI，3.2 kSPS）改为 MPU6050（I²C，1 kSPS，含板载温度），采样率与帧长改为 1 kSPS / 1024 点；② 取消独立 LED 模块与按键，改用板载 LED 与 BOOT 键；③ 12 V 风机 + 适配器改为 5 V USB 风扇，电源复用现有 USB 充电器；④ 取消全部耗材类外接件；新增 NFR-08、AC-13 与 R-06（到货排针状态核验）；⑤ 器件规格与数量按实际采购更新。影响范围：物料清单、需求与验收、风险登记册、测试与实验记录模板、两份主文档
变更类型：首次发布 / 需求变更 / 设计变更 / 计划调整 / 勘误。需求变更须同步更新“1-需求与验收”与两份主文档。
