Zichuan-ALT/vibration-monitor/experiments/2026-10-28-风道堵塞工况.md

# 风道堵塞工况实验记录

**日期**：2026-10-28
**主题**：8.1 震动状态监测器 · 第二类故障（气动负载恶化）与双通道互补性验证

---

## 1. 实验目的

验证温度通道的实际价值：

1. 风道堵塞能否被监测系统识别？
2. 哪些指标对堵塞敏感且单调？
3. 堵塞与转子不平衡的**特征方向是否不同**（能否据此区分故障类型）？

## 2. 装置与条件

| 项目 | 内容 |
|---|---|
| 被测对象 | YD9225HSL 直流无刷风扇，DC 5V 0.20 A，92×92×25 mm |
| 振动传感 | MPU6050，固定于风扇外框（与不平衡实验同一位置） |
| 温度传感 | DS18B20，探头置于**进风面前方、电机轮毂边缘**，用透明胶带固定（见 `evidence/ds18b20_probe.jpg`） |
| 采样 | 1024 点 @ 1 kSPS，带限 RMS 10~260 Hz |
| 基线 | 实验前自学习 15 帧，μ ≈ 0.094 g，σ ≈ 0.011 g，阈值 0.1279 / 0.1676 g |
| 遮挡方式 | 用硬纸板遮挡风扇进风面，按面积估算遮挡比例 |
| 稳定时间 | 每组遮挡后等待 **5 分钟**（τ ≈ 30 s，约 10 个时间常数） |

## 3. 数据

| 工况 | 遮挡比例 | 温度 | ΔT | 振动 RMS | 1× 峰值 | 转频 |
|---|---|---|---|---|---|---|
| ① 正常 | 0 % | **24.05 ℃** | — | **0.0867 g** | 0.0773 g | 34.5 Hz |
| ② 中度 | **50 %** | **24.67 ℃** | **+0.62 ℃** | 0.0589 g（−32 %） | 0.0487 g | 34.2 Hz |
| ③ 重度 | **80 %** | **24.85 ℃** | **+0.80 ℃** | 0.0605 g（−30 %） | **0.0242 g** | **31.5 Hz** |

每组采集 21~22 帧（每帧间隔 2 s）。

温度读数在各组内**完全恒定**（如工况② 全程 24.62~24.69 ℃），
说明 5 分钟等待已使热状态充分稳定。

## 4. 分析

### 4.1 单调性检验

判断一个指标能否用于监测，首先看它是否随故障程度单调变化：

| 指标 | ① → ② → ③ | 单调性 | 可用于判据 |
|---|---|---|---|
| **温度** | 24.05 → 24.67 → 24.85 | ✅ **单调↑** | **是** |
| **1× 峰值** | 0.0773 → 0.0487 → 0.0242 | ✅ **单调↓** | **是** |
| **转频** | 34.5 → 34.2 → 31.5 Hz | ✅ **单调↓** | **是** |
| 振动 RMS | 0.0867 → 0.0589 → 0.0605 | ❌ 非单调 | **否** |

**重要发现**：振动 RMS 在 50 % 与 80 % 遮挡之间几乎不变（0.0589 与 0.0605），
若仅以 RMS 作为堵塞判据，50 % 与 80 % 无法区分。

### 4.2 物理机理

堵塞进风面 → 风量减少 → 电机气动负载增大：

```
① 负载增大 → 转速下降     34.5 → 31.5 Hz（−8.7 %）
② 散热变差 → 外壳温度上升  +0.80 ℃
③ 气动激励减少 → 1× 峰值下降 0.0773 → 0.0242（−69 %）
```

振动下降的原因是风扇振动中的**气动成分**（湍流、叶片切割气流）
随风量减少而减弱；机械成分（转子不平衡、轴承）基本不变。
因此振动总能量下降，而 1× 分量下降更显著。

### 4.3 与转子不平衡的对比（双通道互补性的核心证据）

| 故障类型 | 温度 | 转频 | 1× 峰值 | 振动 RMS |
|---|---|---|---|---|
| **转子不平衡** | 基本不变 | 基本不变 | **↑↑↑（20~65 倍）** | ↑↑↑ |
| **风道堵塞** | **↑ +0.6~0.8 ℃** | **↓ 8.7 %** | **↓ 69 %** | ↓ 约 30 % |

**两类故障的特征方向完全相反。**

> 若系统只装振动传感器：风道堵塞会使振动下降 32 %，
> 系统会判定"设备状态改善"，**故障被完全掩盖**。
>
> 只有引入温度通道，才能识别"温度上升 + 振动下降 + 转频下降"
> 这一组独特特征，从而区分气动类故障与机械类故障。

这直接证明了本项目采用**双通道设计**的必要性，
也是手册"至少 2 路有意义的传感器输入"要求的实际含义。

## 5. 局限与说明

1. **温度探头位置为"轮毂表面 + 附近气流的混合温度"**，不是纯电机外壳温度。
   该位置对风量变化较敏感（风量减少→前方空气变热），因此适合检测散热恶化类故障；
   但若需精确评估绕组温升，应改为让探头金属管**直接贴合轮毂表面**并做隔热处理。
   本次未移动探头，以保持与前序实验条件一致。
2. **遮挡比例为主观估算**（按面积目测），未使用标准化风阻元件，
   因此三组之间的"比例"不宜作为精确自变量使用。
3. **恢复不完全**：拆除遮挡后 3 分钟，温度仍比初始高 0.61 ℃。
   原因是实验持续约 30 分钟，房间环境温度本身已上升，并非传感器迟滞。
4. **电机功率小**（1 W），温升幅度有限（最大 +0.8 ℃）；
   工业风机功率大，同类故障的温升会更显著。
5. 未测量风量，缺少与温度的直接对应关系。

## 6. 结论

1. 温度通道能够识别风道堵塞，温升随遮挡程度单调增加（+0.62 → +0.80 ℃）。
2. 转频与 1× 峰值同样单调，可作为堵塞的辅助判据。
3. **振动 RMS 对堵塞非单调，不能单独作为判据**。
4. 堵塞与不平衡的特征方向相反，双通道可实现故障类型区分。
5. 建议的复合判据（供后续实现）：
   - 温度较基线升高 > 1.5 ℃ 且持续 3 分钟 → 提示散热异常
   - 同时振动 RMS 未上升 → 判定为气动类故障（风道堵塞/滤网脏堵）
   - 振动 1× 显著上升 → 判定为机械类故障（不平衡/轴承）

## 7. 待补充

- [ ] 将上述复合判据写入固件（当前固件仅有振动单判据）
- [ ] 用标准风阻元件（不同目数的滤网）重做，得到定量关系
- [ ] 堵塞工况下长时间运行，观察温度与转速的长期趋势
