Zichuan-ALT/vibration-monitor/experiments/2026-10-26-不平衡工况.md

# 不平衡工况实验记录

**日期**：2026-10-26
**主题**：8.1 震动状态监测器 · 工况实验（转子不平衡）
**执行**：孙良言

---

## 1. 实验目的

验证本方案能否通过振动特征值的变化，识别旋转设备从"平衡"到"不平衡"的状态演变，
并据此确定报警阈值。

## 2. 装置与条件

| 项目 | 内容 |
|---|---|
| 主控 | ESP32-WROOM-32（CH340C，已焊针） |
| 传感器 | MPU6050（GY-521，原厂芯，I²C 地址 0x68） |
| 安装位置 | 传感器固定于风扇**外框**，靠近中心轴承 |
| 被测对象 | YD9225HSL 直流无刷风扇，DC 5V 0.20A，92×92×25 mm |
| 风扇固定 | 四角粘接于桌面，运转时无整体位移 |
| 供电 | USB 5 V 充电器 |
| 采样 | 1024 点 @ 1 kSPS（实测 999.7 Hz，误差 −0.03 %） |
| 分析带宽 | 10 ~ 260 Hz（带限 RMS，剔除 < 10 Hz 安装晃动） |
| 基频带 | 20 ~ 45 Hz |
| 配重材料 | 蓝丁胶，整条 11.25 g，按长度等分后取用 |
| 配重位置 | **单片扇叶**，距轴心约 35 mm（三组工况同一位置） |

## 3. 数据

| 工况 | 配重 | 带内 RMS (g) | 基频带峰值 (g) | 峰值频率 (Hz) | 换算转速 (RPM) | 帧数 | 波动 |
|---|---|---|---|---|---|---|---|
| ① 基准 | 0 g | **0.0574** | 0.0292 | 32.2 | 1932 | 7 | ±19.4 % |
| ② 轻微 | **0.35 g** | **1.4723** | 1.6605 | 33.2 | 1992 | 6 | ±2.3 % |
| ③ 明显 | **0.70 g** | **2.6816** | 2.8015 | 31.2 | 1872 | 6 | ±0.5 % |

原始单帧数据（带内 RMS / 基频峰值 / 频率）

```
① 0.0680/0.0278/32.2   0.0451/0.0273/32.2   0.0373/0.0347/33.2
  0.0578/0.0277/32.2   0.0590/0.0281/32.2   0.0669/0.0299/32.2
  0.0680/0.0289/32.2

② 1.4312/1.5772/33.2   1.4625/1.6432/33.2   1.4689/1.6663/33.2
  1.5177/1.7365/33.2   1.5141/1.7321/33.2   1.4395/1.6078/33.2

③ 2.7260/2.6597/31.2   2.6393/2.9426/31.2   2.6538/2.8727/31.2
  2.7283/2.6911/31.2   2.6933/2.8124/31.2   2.6490/2.8303/31.2
```

## 4. 分析

### 4.1 灵敏度

0.35 g 配重约为转子质量的 0.4 %，却使带内 RMS 上升 **25.7 倍**
（0.0574 → 1.4723 g），基频带峰值上升 **56.9 倍**。

说明本方案对该类小型旋转设备的不平衡极为敏感。

### 4.2 响应为亚线性

配重由 0.35 g 加倍到 0.70 g，RMS 仅上升 **1.8 倍**（而非 2 倍）。

原因判断：风扇运转频率（31~33 Hz）接近"风扇 + 固定方式"构成的系统共振频率，
在共振区内阻尼与非线性使响应增长放缓。

理论校核（0.35 g、35 mm、32 Hz）：

```
F = m·r·ω² = 0.35e-3 × 0.035 × (2π×32)² ≈ 0.49 N
a = F / M_rotor = 0.49 / 0.09 ≈ 5.5 m/s² ≈ 0.56 g（峰值）
实测峰值 = 1.4723 × √2 ≈ 2.08 g
放大倍数 ≈ 3.7 倍  → 共振放大（Q ≈ 3.7）
```

### 4.3 量程约束

曾尝试 2.8 g 配重，实测带内 RMS 达 **3.05 g**，峰值约 4.3 g，
**超出 MPU6050 设定的 ±4 g 量程**，波形削顶导致数据失真，故弃用。

据此把工况配重上限控制在 **0.70 g**。

### 4.4 转速观测的分辨率限制

三组工况测得的峰值频率分别为 32.2 / 33.2 / 31.2 Hz，
差值均在 **±1 个频率分辨单元**（Δf = fs/N = 0.977 Hz）以内，
**不足以判定转速是否真实变化**。

若要精确观测转速，需加长帧长（提高频率分辨率）或加装转速传感器。

### 4.5 会话之间的漂移

同一天内不同时段测得的风扇转频曾为 35.2 Hz 与 32.2 Hz（差 8 %），
基准 RMS 曾为 0.1123 g 与 0.0574 g（差约 2 倍）。

原因：供电电压差异、以及拆装过程中传感器耦合状态改变。

**结论：不同次测量之间不可直接比较，三组工况必须在同一次装配、同一供电下连续完成。**

## 5. 阈值确定

由工况① 的均值与标准差推算（基线自学习法的简化应用）：

```
μ = 0.0574 g ,  σ ≈ 0.011 g

注意阈值 = μ + 3σ ≈ 0.090 g
报警阈值 = μ + 6σ ≈ 0.123 g
```

验证：

| 工况 | 实测 RMS | 相对注意阈值 | 判定 |
|---|---|---|---|
| ① 基准 | 0.0574 g | 0.64 × | 正常 |
| ② 0.35 g | 1.4723 g | **16 ×** | 报警 |
| ③ 0.70 g | 2.6816 g | **30 ×** | 报警 |

三种工况被清晰区分。

## 6. 结论

1. 本方案能够可靠识别旋转设备由平衡到不平衡的状态变化，灵敏度满足要求。
2. 演示用小型风扇（转子约 90 g）对配重极敏感，配重须限制在 **≤ 0.70 g**，否则超出 ±4 g 量程。
3. 响应呈亚线性，系接近系统共振所致；该现象在旋转机械中常见，需在报告中说明。
4. 阈值采用 μ+3σ / μ+6σ 可有效区分正常与不平衡工况。
5. 后续自动化时，基线自学习须在**设备已固定、工况稳定**后执行，并在同一会话内完成标定。

## 7. 频谱对比（同日补测）

对三种工况各采集一帧完整幅值谱（1024 点、Hann 窗、511 个频点，分辨率 0.977 Hz），
原始数据见 `experiments/data/spectrum_*.csv`。

### 7.1 图谱

| 文件 | 内容 |
|---|---|
| `spectra_compare.png` | 三工况叠加对比（全带 0–500 Hz + 低频放大 0–120 Hz） |
| `spectrum_工况1-基准_0g_.png` | 工况① 单张 |
| `spectrum_工况2-轻微不平衡_0_35g_.png` | 工况② 单张 |
| `spectrum_工况3-明显不平衡_0_70g_.png` | 工况③ 单张 |

### 7.2 关键谱线

| 工况 | 1× 转频 | 1× 幅值 | 带内 RMS | 3× 幅值 |
|---|---|---|---|---|
| ① 0 g | 33.2 Hz | 0.0492 g | 0.0516 g | ~0.0005 g |
| ② 0.35 g | 34.2 Hz | **1.9480 g** | 1.8067 g | 0.25 g |
| ③ 0.70 g | 33.2 Hz | **3.2130 g** | 2.9874 g | 0.58 g |

1× 幅值增长 **39.6 倍 → 65.3 倍**；带内 RMS 增长 **35 倍 → 58 倍**。

### 7.3 谐波系列同步抬升

工况① 的谱上可清楚看到 1×、3×（约 100 Hz）、4×（约 133 Hz）、7×（约 232 Hz）
等谐波；配重增加后，**整条谐波系列按同一比例上升**，而非单一频率突变。

这是转子不平衡的典型谱特征：不平衡力随转速以 1× 正弦变化，其谐波由
机架与叶片的非线性传递产生。该特征可用于与轴承损伤（高频冲击、
非整数倍频率）等其他故障模式区分。

### 7.4 由频谱反推叶片数

```
叶片通过频率 = 叶片数 × 转频
实测谱峰 ~232 Hz ，转频 33.2 Hz
232 ÷ 33.2 ≈ 7.0
```

反推该风扇为 **7 叶片**，与实物一致。此为频谱分析的有效性交叉验证
——仅凭频谱即可推断转子结构参数。

### 7.5 动态范围

工况① 主峰 0.0492 g，谐波间谷底约 0.0005 g，动态范围约 **100 倍（40 dB）**。
谱线锐利、无裙边拖尾，说明采样定时与窗函数使用正确。

## 8. 待补充

- [ ] 遮挡风道（气动负载变化）工况
- [ ] 温度通道（DS18B20）联合测量
- [ ] 长时间（≥ 2 h）稳定性与误报率统计
- [ ] 配重精确称重（当前为等分法估算，不确定度约 ±10 %）
