Zichuan-ALT/vibration-monitor/experiments/2026-10-26-系统联调.md

# 系统联调记录 —— 端到端验证

**日期**：2026-10-26
**主题**：8.1 震动状态监测器 · 端到端联调（真实振动 → 边缘判定 → MQTT → 仪表板 → 报警）

---

## 1. 验证目标

确认完整数据链路可用，且**判定在边缘完成**（ESP32 自学习基线并判定状态），
服务端仅负责传输、存储与展示。

```
MPU6050 → ESP32（采样 + FFT + 带限 RMS + 基线自学习 + 迟滞判定）
        → Wi-Fi → MQTT → Node-RED（aedes broker）
        → 仪表板（实时/趋势） + SQLite（历史） + 日志文件
```

## 2. 环境

| 项目 | 值 |
|---|---|
| 节点 | ESP32-WROOM-32，COM8，固件 `09_mqtt_telemetry` |
| 传感器 | MPU6050（I²C 0x68），固定于风扇外框 |
| 被测对象 | YD9225HSL 5 V 风扇，实测转频 34.2~35.2 Hz（约 2050~2110 RPM） |
| 网络 | 手机热点 `XiXiaomi`（2.4 GHz，WPA2） |
| 笔记本 | 10.77.48.14（热点 DHCP） |
| 服务端 | Node-RED 5.0.8，aedes broker 1883，仪表板 1880/ui |
| 数据库 | SQLite `vibration.db`，表 `readings` |

## 3. 固件工作流程

1. 连接 Wi-Fi、连接 MQTT broker
2. **基线自学习**：连续采集 15 帧（每帧 1024 点 @ 1 kSPS），
   计算带内 RMS 的均值 μ 与标准差 σ
3. 阈值：注意 = μ + 3σ，报警 = μ + 6σ
   （σ 下限保护：不小于 0.15 μ，避免基线过稳导致阈值过紧）
4. 循环：每 2 s 测量一帧并上报；判定采用迟滞
   （升级需连续 3 帧确认，降级需连续 5 帧确认）

上报主题：`smartcampus/vib/{node_id}/state`

```json
{"node":"esp32-01","seq":105,"rms":0.0598,"peak":0.0453,
 "fpeak":35.2,"tchip":24.4,"state":"normal",
 "warn":0.0763,"alarm":0.1000}
```

## 4. 自学习结果

```
[ 1/15] RMS = 0.0508 g
[ 2/15] RMS = 0.0492 g
...
[15/15] RMS = 0.0558 g

基线: mu = 0.0526 g,  sigma = 0.0079 g
阈值: 注意 = 0.0763 g,  报警 = 0.1000 g
```

15 帧 RMS 落在 0.0492~0.0569 g，一致性良好（σ/μ = 15 %）。

## 5. 端到端验证结果

### 5.1 通信与存储

| 检查项 | 结果 |
|---|---|
| Wi-Fi 连接 | ✅ 热点 99 % 信号 |
| MQTT 上报 | ✅ 持续成功，无断连 |
| Node-RED 接收 | ✅ 累计 300+ 条 |
| SQLite 写入 | ✅ 每 2 s 一行，字段完整 |
| 日志文件 | ✅ `mqtt_received.log` 按行追加 |

### 5.2 状态判定演示

| 阶段 | 配重 | 带内 RMS | 1× 峰值 | 状态 |
|---|---|---|---|---|
| 正常工况 | 0 g | 0.050~0.070 g | 0.035~0.048 g | **normal** |
| 加 0.35 g 后 | 0.35 g | **0.52~0.63 g** | 0.66~0.70 g @ 34.2 Hz | **alarm** |

- RMS 上升约 **10 倍**，远超报警阈值 0.100 g
- 状态在连续 3 帧确认后由 normal 翻转为 alarm（约 6 s）
- 仪表板：RMS 仪表盘整圈变红，报警等级显示"报警"，
  维修建议显示"振动异常：建议停机检查动平衡与轴承"
- 趋势图记录到**由 0.06 陡升至 0.6 的阶跃**，即加配重的时刻

### 5.3 证据文件

| 文件 | 内容 |
|---|---|
| `evidence/dashboard_live_normal.png` | 正常工况下的仪表板 |
| `evidence/dashboard_live_alarm.png` | 报警工况下的仪表板（含趋势阶跃） |

## 6. 发现与说明

1. **阈值必须由基线自学习得到**。此前用固定的 0.030/0.060 g 作占位值，
   与实际噪声水平不符；自学习得到的 0.0763/0.1000 g 与实测数据吻合。

2. **同一装置在不同次装配下绝对幅值会漂移**（基准 RMS 曾出现 0.0516 与 0.1123 两种量级），
   因此每次装配后必须重新自学习基线。固件支持串口发送 `r` 重新学习。

3. **仪表盘量程需按工况设置**。RMS 在正常与严重不平衡之间跨越约 10~60 倍，
   线性量程无法兼顾；最终取 0~0.5 g（正常工况可读），
   严重不平衡时指针顶到上限并伴随整圈变红，视觉上仍能明确表达"越限"。

4. **服务端不再重复判定**。状态与阈值均由 ESP32 上报，
   Node-RED 仅做映射（英文状态 → 中文等级与建议）、存储与展示，
   符合"边缘处理而非原始转发"的设计要求。

## 6. 调试记录：历史曲线空白问题

联调过程中"历史查询"页始终空白，排查过程记录如下，可作为同类问题的参考。

### 6.1 现象

- 数据库有 600+ 条记录，直接查库能返回 200 条
- 仪表板"历史查询"页的图表框架正常，但**没有曲线**
- Node-RED 每 30 秒输出一条警告：`[ui_chart:数据库历史曲线] Bad data inject`

### 6.2 排查与修复（三个独立问题叠加）

**问题一：数据格式不符合节点要求**

查看 `node_modules/node-red-dashboard/nodes/ui_chart.js:74` 可知，批量注入时
payload 必须是：

```js
[{ series: ['名称'], data: [[x, y], ...] }]
```

而原实现发送的是 `[{x: 时间, y: 值}]`，缺少 `series` 与 `data` 字段，
被节点判定为非法并丢弃，因此每 30 秒报一次 `Bad data inject`。

修复：改为该节点要求的 `{series, data}` 结构。

**问题二：批量格式能通过校验但画不出线**

改格式后警告消失，但图表仍无曲线。逐条比对发现，该版本 UI 对
"单点 + `msg.timestamp`" 与"批量数组"走的是两条不同代码路径，
其中单点路径（实时趋势图所用）经验证可靠。

修复：改为先发 `{payload: []}` 清空，再逐条发送
`{ payload: <数值>, timestamp: <毫秒时间戳> }`。

**问题三（根本原因）：`removeOlder` 设为 0 导致所有点被立即丢弃**

检查节点配置发现历史图的 `removeOlder` 为 `"0"`、`removeOlderUnit` 为 `"3600"`。
原意是"永不删除历史点"，但该参数语义是"**只保留最近 N 小时**"，
`0` 意味着保留窗口为 0 —— 客户端每收到一个点就立刻判定为过期并丢弃。

**实时趋势图的同一参数是 `60`（60 分钟），所以一直正常**；
两者只差这一个数字，行为却完全不同。

修复：改为 `removeOlder = "24"`、`removeOlderUnit = "3600"`（保留 24 小时）。

### 6.3 修复后的验证

历史页正确显示 16:28–16:38 的完整曲线：

| 时段 | RMS | 说明 |
|---|---|---|
| 16:28–16:30 | ≈ 0 | 风扇停转 |
| 16:31:30–16:33:00 | **0.6 ~ 0.8 g** | 0.35 g 配重的报警段 |
| 16:33 之后 | ≈ 0 | 拆配重、停机 |

### 6.4 经验

1. 第三方节点的**配置语义不能靠猜**，`removeOlder = 0` 这种"看起来像关闭"
   的值往往是"窗口为 0"，恰好是相反的效果。
2. 排查时**先对比同项目中"能正常工作"的同类节点**，差异往往一目了然
   —— 本次的突破口正是实时趋势图的 `removeOlder = 60`。
3. 读**源码**比读文档快：`Bad data inject` 这个提示在源码里只有一处，
   定位后立即看到它对 payload 结构的要求。

## 7. store-and-forward 验证

### 7.1 固件 v2 的改进

| 改进 | 说明 |
|---|---|
| 非阻塞重连 | WiFi/MQTT 连接检查移出主流程，测量节奏不因网络中断而停止 |
| 环形缓冲 | 60 条（约 2 分钟），网络恢复后按原顺序补发 |
| **NTP 时间戳** | 每条数据携带**测量时刻**的 Unix 时间（设备用 NTP 对时），补发数据在服务端仍落在正确位置 |
| 基线下限保护 | 若自学习的 μ < 0.010 g，判定设备未运行并**拒绝该基线** |

### 7.2 基线自学习陷阱（实测遇到）

一次烧录时风扇恰好停转，自学习得到 μ ≈ 0.005 g（传感器噪声底），
推算阈值约 0.008 g。此时若设备启动，RMS 约 0.05 g 会立即误报警。

**因此加入下限保护**：

```
若 baseMu < 0.010 g  →  拒绝基线，状态上报 uncalibrated
                        仪表板显示"未标定"并提示重新学习
```

### 7.3 断网-恢复测试

**测试方法**：用 `netsh wlan disconnect` 断开笔记本 Wi-Fi，模拟节点与 broker 失联，
30 秒后 `netsh wlan connect` 恢复。

**断网阶段串口输出**：

```
RMS=0.1469 状态=normal 缓冲=1  [离线]
[MQTT] 连接 10.77.48.14:1883 …
[MQTT] 失败 rc=-2
RMS=0.1618 状态=alarm  缓冲=2  [离线]
RMS=0.1122 状态=alarm  缓冲=3  [离线]
```

**恢复阶段**：

```
[MQTT] 已连接
[补发] 5 条已发出，缓冲剩余 0 条
RMS=0.1099 状态=alarm 缓冲=0
```

**数据库验证**（补发数据的时间戳均落在原始测量时刻）：

| id | 时间 | RMS | 状态 | 与上条间隔 |
|---|---|---|---|---|
| 1648 | 17:01:09 | 0.0568 | normal | 2 s |
| 1649 | 17:01:30 | 0.1469 | normal | **21 s**（断开瞬间） |
| 1650 | 17:01:35 | 0.1618 | alarm | 5 s |
| 1651 | 17:01:41 | 0.1122 | alarm | 6 s |
| 1652 | 17:01:48 | 0.1099 | alarm | 7 s |
| 1653 | 17:01:46 | 0.1052 | alarm | **−2 s** |
| 1654 | 17:01:50 | 0.1087 | alarm | 4 s |
| 1655 | 17:01:52 | 0.1083 | alarm | 2 s |

### 7.4 结论与遗留问题

**结论**：断网期间数据零丢失，恢复后按原测量时刻补发，时间戳准确。

**遗留问题一：断网期间采样周期退化**

`mqtt.connect()` 本身是阻塞的（约 5 s TCP 超时），导致断网时采样周期由 2 s 退化到 5~7 s。
已采取的措施：把重连间隔由 5 s 放宽到 15 s，并把测量移到网络处理**之前**，
使阻塞只影响当轮周期而不丢采样点。

**彻底解决需改用异步 MQTT 客户端**（如 AsyncMqttClient），超出本次课程范围，记入后续改进。

**遗留问题二：个别记录时间戳倒序最大 2 s**

id 1652 与 1653 出现 2 s 倒序，可能与 NTP 在运行中的微调有关。
对趋势展示无影响，但对严格时序分析需注意。

**遗留问题三：基线随装配状态漂移**

同一天内基线曾出现 0.055 g 与 0.10 g 两种水平，与传感器粘接状态、风扇位置有关。
**每次重新装配后必须重新自学习**，这是本方案的操作约束。

## 8. 复现步骤

```powershell
# 1. 服务端
cd C:\Users\孙良言\projects\vibration-monitor\nodered
node-red                       # 1880 编辑器 / 1883 broker

# 2. 烧录固件（确认 SSID / broker IP 与实际网络一致）
arduino-cli upload -p COM8 --fqbn esp32:esp32:esp32 firmware/09_mqtt_telemetry

# 3. 确认设备处于正常工况后上电，等待自学习完成（约 20 s）

# 4. 打开仪表板
#    http://localhost:1880/ui

# 5. 加配重验证报警；如需重新学习基线，串口发送 r
```
