Zichuan-ALT/vibration-monitor/report_p3.py

# -*- coding: utf-8 -*-
"""报告正文 第三部分：第 6~8 章（数据分析与讨论、专业实践、负责任的设计）。"""

# ================================================================= 6 分析
h("6  数据分析与讨论", 1)

h("6.1  检测灵敏度", 2)
para("不平衡实验最直接的结论是这套方案足够灵敏。0.35 g 的配重仅占转子质量"
     "（约 90 g）的 0.4%，却使带内 RMS 从 0.0574 g 上升到 1.4723 g，"
     "即 25.7 倍；1× 峰值更是上升了 56.9 倍。", indent=True)
para("从信噪比看，基准工况的带内 RMS 为 0.0574 g，而静止时（仅传感器噪声）"
     "为 0.0053 g，即正常运转时已有约 10 倍于噪声的信号；"
     "加入 0.35 g 配重后信号再放大 25 倍，与噪声的距离拉大到约 270 倍。"
     "这意味着即便是很轻微的不平衡劣化，也落在可检测范围内。", indent=True)

h("6.2  亚线性响应与共振", 2)
para("配重由 0.35 g 加倍到 0.70 g，理论上不平衡力也应加倍，"
     "但带内 RMS 只上升了 1.82 倍（1.4723 → 2.6816）。这种亚线性行为"
     "提示系统工作在其共振区附近。", indent=True)
para("用不平衡力的公式做一次量级校核。转子不平衡产生的离心力为：", indent=True)
code_block([
    "F = m · r · ω²",
    "  = 0.35e-3 kg × 0.035 m × (2π × 32 Hz)²",
    "  ≈ 0.49 N",
    "",
    "若转子质量 M ≈ 0.09 kg，则对应的刚体加速度：",
    "a = F / M ≈ 5.4 m/s² ≈ 0.56 g（峰值）",
    "",
    "而实测 1× 峰值 1.6605 g，约为推算值的 3 倍 → 放大倍数 Q ≈ 3.7",
])
para("放大倍数接近 4，说明风扇与台架构成的系统在 31~35 Hz 附近存在共振。"
     "这解释了亚线性：配重加倍虽然使激励加倍，但系统已进入阻尼主导区，"
     "响应增长被压制。", indent=True)
para("这一现象有两点实践含义。其一，共振区的响应对配重不敏感，"
     "单靠幅值绝对值难以判断不平衡的严重程度，需要结合转速与谐波结构；"
     "其二，若能把系统固有频率移开工作转速（例如加固台架），"
     "响应会更接近线性，定量关系也更可靠。")

h("6.3  支撑刚度的影响", 2)
para("这是本项目最有价值的一次实测发现，也是一次判断失误的记录。", indent=True)

h("6.3.1  现象", 3)
para("同一台风扇、同一转速（35.2 Hz），振动 RMS 在一天之内出现了"
     "0.055 g 与 0.207 g 两种水平，相差 3.7 倍。这个差异远大于配重实验本身的"
     "变化幅度，若不查清，此前所有数据都无法解释。", indent=True)

h("6.3.2  第一次判断：错误", 3)
para("最初的怀疑对象是传感器粘接。理由是传感器用胶带固定在风扇外框上，"
     "反复接线过程中可能被扯松。于是做了一个「按压测试」："
     "用手指轻按传感器模块，观察 RMS 变化。结果按压时 RMS 由 0.1846 g "
     "降到 0.0796 g（−56.9%），进一步「证实」了胶松的猜想。", indent=True)
para("然而重新粘贴传感器后再测，RMS 反而是 0.2068 g，比之前更高。"
     "这次失败暴露了按压测试的方法缺陷：**按压传感器时，手指同时也给"
     "整个风扇结构增加了阻尼**。两个变量（传感器粘接刚度、结构阻尼）被混在一起，"
     "无法区分到底是哪一个引起了变化。", indent=True)

h("6.3.3  第二次判断：正确", 3)
para("改进后的做法是改变按压对象：改为按压**风扇底座**，"
     "手指远离传感器，只改变结构约束而不影响粘接。结果 RMS 由 0.2068 g "
     "降到 0.0556 g（−73.1%），且这个数值与此前的历史稳定值 0.055 g 几乎一致。", indent=True)
para("结论由此明确：不是传感器松了，而是**风扇整体在桌面上跳动**——"
     "刚体运动被传感器一并测到了。", indent=True)

h("6.3.4  判别指标", 3)
para("两类状态在谱特征上的差异提供了一条可用的在线判据。", indent=True)
table("表 6-1　支撑状态与谱特征的关系",
      ["状态", "基频峰值", "带内 RMS", "峰值/RMS", "说明"],
      [["固定良好", "0.042 ~ 0.062 g", "0.0556 g", "≈ 1.0", "能量集中在 1× 附近"],
       ["风扇晃动", "0.066 ~ 0.079 g", "0.1966 g", "0.36", "额外能量分布在非 1× 频段"]],
      [Cm(2.4), Cm(4.0), Cm(3.0), Cm(2.2), Cm(5.0)], size=8.8,
      align_map=["c", "c", "c", "c", "l"])
para("风扇晃动时，1× 峰值几乎不变（因为机械激励没变），而带内 RMS 大幅上升"
     "（因为叠加了刚体运动），因此两者之比显著小于 1。"
     "把「峰值/RMS」作为一个辅助诊断量，可以在线判断当前测量是否可信。")

h("6.3.5  意义", 3)
para("这次经历说明，支撑刚度对振动测量的影响（3.7 倍）远大于传感器粘接质量。"
     "根本原因是：传感器无法区分「设备自身的结构振动」与「设备整体的刚体运动」。"
     "工业标准要求振动测量必须相对于刚性基础进行，机组基础须有足够刚度，"
     "原因正在于此。", indent=True)
para("对方法论的启示更值得记录：当怀疑某个因素时，应设计能**只改变该因素**的实验；"
     "若两个变量同时被改变，即便结果「符合预期」，也不能作为证据。", indent=True)

h("6.4  温度通道的时间常数", 2)
para("由 5.2.2 的升温/降温实验可估出温度通道的时间常数 τ ≈ 25~30 s，"
     "比振动通道（秒级）慢一个数量级以上。这决定了两条通道的报警策略不能相同：", indent=True)
bullets([
    ("振动报警：连续 3 帧（约 6 s）确认即可升级，因为不平衡引起的振动变化是瞬时的；", False),
    ("温度报警：应设置分钟级确认延时（例如连续 3 分钟超限），"
     "否则手触、热风、短暂遮挡都会造成误报。", False),
])
para("本项目当前固件只实现了振动判据，温度仅作展示。若要把温度纳入判定，"
     "需要按上述结论单独设计延时逻辑，这一点列在后续工作中。")

h("6.5  阈值确定方法", 2)
para("阈值采用基线自学习而非固定值，理由在 3.3.4 已说明。本节给出两组实测验证。", indent=True)

table("表 6-2　两次自学习得到的基线（不同安装状态下）",
      ["场次", "μ", "σ", "注意阈值 μ+3σ", "报警阈值 μ+6σ", "当时工况"],
      [["第一次", "0.0526 g", "0.0079 g", "0.0763 g", "0.1000 g", "风扇运转（较紧固定）"],
       ["第二次", "0.0942 g", "0.0112 g", "0.1279 g", "0.1676 g", "风扇运转（支撑偏软）"]],
      [Cm(1.8), Cm(2.4), Cm(2.4), Cm(3.2), Cm(3.2), Cm(4.2)], size=8.6,
      align_map=["c", "c", "c", "c", "c", "l"])

para("两次的 μ 相差近 1.8 倍，而阈值随之上移，说明自学习确实起到了自适应作用。"
     "若采用固定阈值 0.100 g，则在第二次的安装状态下正常运转就会被判为报警。", indent=True)
para("判定效果验证：在 μ=0.0526 g 那一场，加入 0.35 g 配重后 RMS 达 1.47 g，"
     "为报警阈值的 14.7 倍；0.70 g 配重达 2.68 g，为 26.8 倍。"
     "三种工况被干净地分开，迟滞机制也没有造成来回抖动。", indent=True)
para("自学习机制的脆弱点同样需要说明：它要求设备在自学习期间处于**代表性工况**。"
     "实测中曾出现风扇恰好停转时烧录固件的情形，此时学到的 μ 仅 0.0053 g，"
     "推算阈值约 0.008 g，设备一启动就会误报。这正是加入「μ 低于 0.010 g 时拒绝基线」"
     "这条下限保护的原因（见 4.2 节）。")

h("6.6  与设计预期的偏差", 2)
para("把设计阶段的估算与实测结果并列，可以看到三处明显偏差，"
     "每一处都改变了后续设计。", indent=True)

table("表 6-3　设计预期与实测对比",
      ["项目", "设计预期", "实测值", "偏差原因与应对"],
      [["噪声底", "0.0005 ~ 0.001 g", "0.0053 g",
        "估算时未计入 DLPF 带宽（256 Hz）对噪声的积分；"
        "改为实测并用带限 RMS 后降到与手册推算一致"],
       ["风扇转频", "1700 RPM → 28.3 Hz", "2050 ~ 2120 RPM → 34~35 Hz",
        "铭牌标称与实际不符（偏高约 21%）；基频带由 15~35 Hz 放宽到 20~45 Hz"],
       ["不平衡响应", "线性增长", "亚线性（加倍配重 → 1.8 倍响应）",
        "工作转速接近系统共振；改以 1× 峰值与谐波结构为主要判据"]],
      [Cm(2.2), Cm(4.2), Cm(4.6), Cm(5.8)], size=8.4,
      align_map=["c", "l", "l", "l"])

para("三处偏差有一个共同点：都是「设计阶段的估算过于乐观或依赖了不可靠的来源」"
     "（经验值、铭牌参数）。这印证了一条工程常识——关键参数必须实测，"
     "尤其当它决定后续所有设计时。", indent=True)

h("6.7  局限", 2)
para("本方案有以下局限，需在解读数据时一并考虑。", indent=True)
bullets([
    ("单一测点、单轴分析。虽然同时采集三轴并自动选择能量最大的轴，"
     "但本质上仍是单点测量，无法做相位分析或故障定位；", False),
    ("无转速传感器。转频依靠频谱推断，频率分辨率 0.977 Hz 限制了转速变化的观测精度，"
     "三组工况测得的 32.2/33.2/31.2 Hz 差异均在 1 个分辨单元以内，不能据此判断转速是否真实变化；", False),
    ("温度未做绝对标定。本次未取得冰水混合物作为一级参考点，"
     "温度精度依赖 DS18B20 出厂标定（±0.5 ℃）；", False),
    ("演示对象与工业机组可比性有限。92 mm 风机转子仅约 90 g，"
     "对配重极其敏感（0.7 g 即接近量程上限），"
     "而工业风机的转子质量大得多，同质量配重的相对影响要小很多；", False),
    ("未做长时间误报率统计。目前只有单次数小时的运行记录，"
     "不足以给出有统计意义的误报率指标；", False),
    ("温度未纳入判据。温度通道目前只做展示与记录，"
     "尚未实现「温度升 + 振动降 → 气动故障」的复合判据。", False),
])

# ================================================================= 7 专业实践
h("7  专业实践", 1)

h("7.1  版本控制与协作", 2)
para("全部代码、文档、实验数据与证据照片都纳入 Git 仓库管理，"
     "共 85 个受控文件、20 余次提交，托管于 GitHub。"
     "提交信息采用「类型(范围): 摘要」的格式，例如：", indent=True)
code_block([
    "feat(firmware): 1 kHz 采样 + FFT 特征提取，实测噪声底",
    "test: 不平衡工况实验（0 / 0.35 / 0.70 g）三级数据",
    "fix: 历史曲线空白 —— removeOlder 设为 0 导致所有点被丢弃",
    "docs: 同步 2026-10-25 实测结论到实施方案",
])
para("仓库目录按职能划分：firmware/ 存放 11 个固件，experiments/ 存放实验记录与原始数据，"
     "evidence/ 存放实物照片与界面截图，tools/ 存放抓取与绘图脚本，"
     "nodered/ 存放流程定义。这样任何人拿到仓库都能独立复现。", indent=True)
para("一个值得记录的做法是：每次实验结束后，当天就把实验记录（含原始数据、"
     "分析过程与结论）写成 Markdown 文档提交。事后写报告时不需要回忆，"
     "所有数字都有出处。", indent=True)

h("7.2  风险管理", 2)
para("项目初期建立了 13 项风险登记册，覆盖供应链、技术、进度与安全四类。"
     "实施过程中实际发生了三项，均有对应的应对措施：", indent=True)
table("表 7-1　实际发生的风险与应对",
      ["风险", "影响", "应对措施"],
      [["传感器到货为不带排针的版本", "无法直接插接", "更换为带排针的版本；"
        "此后采购前先确认是否带排针"],
       ["校园网屏蔽代码托管域名", "无法推送代码", "改用手机热点；"
        "本地提交保证不丢，网络恢复后补推"],
       ["传感器安装状态漂移", "数据不可比", "每次装配后重新自学习基线；"
        "同组实验在一次装配内连续完成"]],
      [Cm(5.0), Cm(4.0), Cm(7.8)], size=8.6, align_map=["l", "l", "l"])

h("7.3  受控文档", 2)
para("项目维护一份受控文档台账，包含 9 张表：需求追踪矩阵、物料清单、"
     "测试记录、工况实验记录、问题日志、变更记录、会议记录、风险登记册与交付清单。"
     "台账的作用是让「改了什么都留下痕迹」，例如需求变更时能追到受影响的设计与测试项。", indent=True)

h("7.4  调试记录", 2)
para("本项目的三个典型问题，其排查过程本身比结论更有参考价值。", indent=True)

h("7.4.1  历史曲线空白", 3)
para("现象：数据库中有 600 多条记录，直接查库能返回数据，"
     "但仪表板「历史查询」页始终空白，且 Node-RED 每 30 s 输出一条 "
     "[ui_chart] Bad data inject 警告。", indent=True)
para("排查分三步。第一步读源码：在 node_modules/node-red-dashboard/nodes/ui_chart.js "
     "中搜索该警告，发现只有一处，条件是 payload 缺少 series 与 data 字段；"
     "按要求改为 [{series, data}] 格式后警告消失，但曲线仍是空的。"
     "第二步对比：发现同项目中实时趋势图一直正常，"
     "两者的配置只差一个参数——removeOlder。第三步验证："
     "实时图的 removeOlder 为 60（分钟），历史图为 0。", indent=True)
para("根本原因是 removeOlder 的语义：它表示「只保留最近 N 个单位的数据」，"
     "设为 0 意味着保留窗口为 0——客户端每收到一个点就立刻判为过期并丢弃。"
     "最初把它理解为「永不删除」，正好相反。改为 24 小时后曲线正常显示。", indent=True)
para("经验：第三方节点的配置语义不能靠猜；排查时优先对比同项目中"
     "「能正常工作的同类节点」，差异往往一目了然；读源码通常比读文档快。")

h("7.4.2  振动读数异常偏高", 3)
para("见 6.3 节。核心教训是实验设计：当怀疑某个因素时，"
     "必须设计只改变该因素的实验，否则结果无法归因。")

h("7.4.3  传感器误判", 3)
para("MPU6050 的 getDeviceID() 返回 0x34 而非数据手册上的 0x68，"
     "一度怀疑买到假芯片。查阅库源码后发现该库对 WHO_AM_I 做了归一化"
     "（取 >>1 后的低 6 位），而寄存器原始值确为 0x68。"
     "教训是：封装层的返回值不一定等于寄存器原值，关键判据应直读底层。")

h("7.5  标准与规范", 2)
para("项目参考了以下资料：ISO 10816 关于机器振动烈度的评价方法"
     "（本方案的速度有效值即对应这一评价量）；MPU6050 与 DS18B20 的数据手册"
     "（噪声密度、量程与分辨率、出厂标定说明）；MQTT 3.1.1 规范"
     "（QoS 等级与报文结构）；以及 Arduino-ESP32 核心库与 arduinoFFT 的 API 文档。", indent=True)

# ================================================================= 8 责任设计
h("8  负责任的设计", 1)

h("8.1  安全", 2)
para("电气方面，系统全部由 USB 5 V 供电，板载最高电压为 5 V，"
     "无市电裸露部分；传感器与主控的逻辑电平为 3.3 V。"
     "接线时明确了「传感器供电接 3V3、SD 模块接 5V」的区别，"
     "并在文档中标注了 VIN 与 VN 两个易混淆引脚（前者为 5 V 电源输入，"
     "后者为 GPIO39 传感器输入，接错会损坏 IO）。", indent=True)
para("机械方面，被测风机工作时转速约 2100 RPM，扇叶外缘线速度较高。"
     "实验中要求配重必须压实贴紧、边缘包覆，通电首秒用手护住风扇确认不甩飞；"
     "离心力估算显示 5 g 配重在 35 mm 半径处承受约 8.6 N（约 0.9 kgf）的拉力，"
     "因此配重上限控制在 0.70 g 并明确禁止加大。", indent=True)
para("数据方面，系统只上传特征值，不上传原始波形，减少了运行状态信息的暴露面。", indent=True)

h("8.2  隐私", 2)
para("本系统采集的是设备振动与温度，不涉及人员信息：没有摄像头、没有麦克风、"
     "也不采集位置数据。设备标识仅使用节点编号（esp32-01），不包含任何个人标识。"
     "服务端运行在本地网络，数据不经过第三方云平台。", indent=True)

h("8.3  可持续性", 2)
para("从三个角度考虑可持续性。其一是器件通用性：所选传感器与主控都是市场上"
     "长期大量供应的通用型号，便于维修替换，不会因某一型号停产而整体报废。"
     "其二是功耗：整机由 USB 5 V 供电，工作电流约 100 mA，"
     "单节点功耗约 0.5 W，长期运行的电费可以忽略。"
     "其三是可维修性：各模块独立，任一部分损坏只需更换该模块，"
     "不需要更换整机。", indent=True)

h("8.4  可维护性与可复制性", 2)
para("可维护性体现在三处：串口提供 r（重新学习基线）与 b（查看网络与缓冲状态）"
     "两个命令，现场无需重新烧录即可重新标定；阈值自适应，不需要人工设定；"
     "断网可用，网络故障不影响本地监测与记录。", indent=True)
para("可复制性方面，方案不依赖任何专有硬件或付费软件："
     "主控与传感器均为通用模块，服务端为开源软件，"
     "代码与文档全部公开在仓库中。第 9 章讨论跨环境复制时的具体差异。")

h("8.5  伦理与社会影响", 2)
para("正面影响是明确的：状态监测能减少非计划停机、延长设备寿命、"
     "降低维护人员的现场作业频次（部分巡检可由远程数据替代）。"
     "潜在风险有两点：一是过度依赖自动报警，运维人员可能逐渐丧失"
     "对设备状态的独立判断能力；二是报警阈值若设置不当，"
     "频繁误报会导致「报警疲劳」，反而使真实报警被忽略。", indent=True)
para("对此的应对是：系统始终同时展示原始数据（RMS、温度、频谱）而不只是"
     "一个状态标签，让人可以复核判断；报警附带维修建议而不仅是等级，"
     "引导使用者理解原因；并在文档中如实说明局限，避免把工具的能力夸大。")
