Zichuan-ALT/vibration-monitor/(commit log)

2026-10-20 feat: 主题 8.1 震动状态监测器 —— 交付物与可运行样机
    交付物（三份受控文档）
    - 项目提案与需求规格说明：17 页，11 项 FR / 9 项 NFR / 13 条 AC
    - 实施方案：25 页，13 个施工步骤，附录 A 记录环境搭建与 7 个故障速查
    - 受控文档台账：9 个工作表，实际支出 ¥119.50，预算上限 ¥150，结余 ¥30.50
    已跑通并验证
    - ESP32 工具链：Arduino IDE + esp32 core 2.0.17（非 3.x，省 1 GB 且 API 一致）
    - Wi-Fi 连接：2.4 GHz 热点，RSSI −34 dBm，双向 ping 0% 丢包
    - MQTT 上报：ESP32 → aedes broker（1883）→ Node-RED mqtt in
    - 仪表板：实时页（2 表盘 + 状态 + 报警等级 +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
    [8.1_受控文档台账.xlsx, 8.1_受控文档台账_需求_BOM_风险_计划.xlsx]
2026-10-25 feat(firmware): MPU6050 接入并完成自检
    新增固件
    - 05_i2c_scan: I2C 总线扫描，确认模块地址
    - 06_mpu6050_test: 传感器自检（三项判据）
    实测结果
    - I2C 扫描: 发现设备 0x68（AD0 悬空）
    - WHO_AM_I 原始寄存器 = 0x68，原厂 MPU6050 确认
    - 库归一化 ID = 0x34（Electronic Cats 库对 WHO_AM_I 取 >>1 的低 6 位）
    - 重力模长 |a| = 0.991 ~ 1.002 g（偏差 0.9%，判据为 ±20%）
    - 静止波动 < 0.01 g，无跳变
    接线
    - VCC-3V3 GND-GND SDA-GPIO21(D21) SCL-GPIO22(D22) AD0-悬空
    备注
    - 串口号由 COM7 变为 COM8（更换 USB 口后 Windows 重新分配）
2026-10-25 feat(firmware): 1 kHz 采样 + FFT 特征提取，实测噪声底
    - 07_sampling_fft: 1024 点 @ 1 kSPS 采样、Hann 窗、FFT、特征值提取
    实测结果（模块静置于桌面）
    - 采样率: 1023 ms / 1024 点，实际 fs = 999.7 Hz，误差 -0.03%（判据 <=0.5%，通过）
    - 噪声底: sigma = 0.0045 g，3sigma = 0.0134 g
    - 速度有效值: 0.01 ~ 0.02 mm/s（10~250 Hz）
    - 全带峰值 0.0009 ~ 0.0014 g，峰值频率随机（18.6/28.3/30.3/84/126 Hz）
    → 无稳定周期性干扰源，测得的是传感器噪声 + 环境随机扰动
    噪声底与数据手册对照
    - MPU6050 加速度噪声密度典型 400 ug/sqrt(Hz)
    - DLPF 带宽 256 Hz → 理论值约 0.0064 g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
2026-10-25 feat(firmware): 台架振动测量 v2，实测转频 35.2 Hz
    新增/改进
    - 08_fan_measure: 三轴同时采集、自动选最强轴
    - RMS 改为带限计算（Parseval，10~260 Hz），剔除 <10 Hz 的安装晃动
    - 单独输出低频 RMS 用于诊断安装牢固度
    - 基频带由 15~35 Hz 放宽到 20~45 Hz（实测转速超出原带边界）
    实测结果（模块固定于风扇外框）
    - 风扇断电: 带内 RMS = 0.0053 g，低频 RMS = 0.0012 g，峰值频率随机
    - 风扇运转: 带内 RMS = 0.048~0.059 g，低频 RMS 不变
    - 谱峰稳定在 34.2~36.1 Hz -> 换算转速 2052~2121 RPM
    - 信噪比约 20 dB（9~11 倍于基线）
    关键发现
    - 实测转速 2052~2121 RPM，高于铭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
2026-10-25 docs: 同步 2026-10-25 实测结论到实施方案
    表 23 固件参数
    - 基频带由 15~35 Hz 改为 20~45 Hz（实测转速 2121 RPM，原带无余量）
    - 分析带宽补充说明：RMS 必须按带限计算，剔除 <10 Hz 的安装晃动
    - 新增两行：实测噪声底 0.0053 g、实测转频 35.2 Hz / 2121 RPM
    步骤 2 传感器自检
    - 澄清 WHO_AM_I 判据：原始寄存器 0x68，Electronic Cats 库归一化后返回 0x34
    （库对 WHO_AM_I 取 >>1 的低 6 位，两者都要核对）
    5.3 关键代码要点
    - arduinoFFT 代码改为 2.x API（模板类 ArduinoFFT<T>、windowing/compute/complexToMagnitude）
    新增 7.4 已完成实测记录（2026-10-25）
    - 表 25b 实测结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
    [8.1_受控文档台账.xlsx]
2026-10-26 test: 记录不平衡工况实验（0 / 0.35 / 0.70 g）
    新增 experiments/2026-10-26-不平衡工况.md
    - 装置与条件、三组工况原始数据、分析、阈值、结论
    - 原始单帧数据全部保留，便于复核
    核心数据
    - 0 g : RMS 0.0574 g, 基频峰值 0.0292 g @ 32.2 Hz
    - 0.35 g : RMS 1.4723 g, 基频峰值 1.6605 g @ 33.2 Hz
    - 0.70 g : RMS 2.6816 g, 基频峰值 2.8015 g @ 31.2 Hz
    主要结论
    - 0.35 g（转子质量 0.4%）使 RMS 上升 25.7 倍，灵敏度满足要求
    - 配重加倍仅使 RMS 上升 1.8 倍（亚线性），系接近系统共振
    - 2.8 g 配重导致峰值 4.3 g 超出 ±4 g 量程削顶，故上限取 0.70 g
    - 频率分辨率 0.977 Hz 不足以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
2026-10-26 feat: 频谱导出与绘图工具链 + 三工况频谱数据
    固件 08_fan_measure v3
    - 串口收到任意字符时导出当前帧 511 点频谱 CSV（#BEGIN ... #END）
    - 保留最强轴的频谱数组
    - 供上位机保存与绘图
    新增工具
    - tools/capture_spectrum.ps1: 抓一帧频谱存 CSV（带工况标签，自动去噪行）
    注意: PowerShell 5.1 需 UTF-8 BOM 才能正确解析中文脚本
    - tools/plot_spectra.py: 读取所有 CSV，输出三工况对比图与单张图
    使用 Microsoft YaHei 中文字体；标注基频带与分析带宽边界
    新增频谱数据 experiments/data/
    - 3 份原始 CSV（各 511 频点，分辨率 0.977 Hz）
    - 4 张 PNG（三工况对比 + 各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
    [spectrum_工况1-基准_0g__20261026_154748.csv, spectrum_工况2-轻微不平衡_0_35g__20261026_154909.csv, spectrum_工况3-明显不平衡_0_70g__20261026_155039.csv]
2026-10-26 feat: 端到端联调完成 —— 真实振动驱动仪表板与报警
    新增固件 09_mqtt_telemetry（完整节点固件）
    - WiFi + MQTT + 1024 点采样 + FFT + 带限 RMS
    - 启动时基线自学习 15 帧，算出 mu、sigma
    - 阈值 = mu+3sigma（注意） / mu+6sigma（报警），sigma 设不低于 0.15mu
    - 迟滞判定：升级连续 3 帧确认，降级连续 5 帧确认
    - 上报 topic smartcampus/vib/esp32-01/state，JSON 含 rms/peak/fpeak/tchip/state/warn/alarm
    - 串口发送 r 可重新学习基线
    服务端流程更新（tools/deploy_flow_v2.py）
    - 判定改由设备完成，服务端只做状态映射（英文 -> 中文等级与建议）
    - 仪表盘量程由 0~4 g 改为 0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
2026-10-26 fix: 修复历史数据图不显示（Bad data inject）
    问题
    - 仪表板"历史查询"页始终空白，Node-RED 每 30 秒警告 [ui_chart] Bad data inject
    根因
    - node-red-dashboard 3.6.6 的 ui_chart 折线图要求 payload 形如
    [{ series: [...], data: [[x, y], ...] }]
    （见 node_modules/node-red-dashboard/nodes/ui_chart.js:74）
    - 原实现发送的是 [{x, y}] 格式，被节点判定为非法并丢弃
    修复
    - func_chart 改为 [Date.parse(ts), rms] 的二维数组，包在 {series, data} 里
    - 先按时间正序排列再绘图
    - tools/plot_history.py: 从 SQLite 读 readings 表，绘制 RMS 历史曲线
    并按 state 标注报警点；时间轴转换为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
2026-10-26 fix: 历史曲线空白 —— removeOlder 设为 0 导致所有点被丢弃
    现象
    - 数据库有 600+ 条记录可正常查询，但仪表板"历史查询"页图表始终空白
    - Node-RED 每 30 秒警告 [ui_chart] Bad data inject
    根因（三个问题叠加）
    1. payload 结构不符合节点要求
    ui_chart.js:74 要求批量注入格式为 [{series, data:[[x,y]]}]
    原实现发送 [{x, y}]，缺字段被丢弃 -> Bad data inject
    2. 改格式后警告消失但仍无曲线
    该版本对"单点 + msg.timestamp"与"批量数组"走两条不同代码路径
    单点路径（实时趋势图所用）已验证可靠
    3. 根本原因: removeOlder 设为 "0"
    该参数语义为"只保留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
2026-10-26 feat: store-and-forward + NTP 时间戳 + 基线下限保护
    固件 09_mqtt_telemetry v2
    - NTP 对时（ntp.aliyun.com / cn.pool.ntp.org），payload 增加 ts 字段（测量时刻 Unix 秒）
    - 环形缓冲 60 条（约 2 分钟），断网时数据入缓冲，恢复后按序补发
    - WiFi / MQTT 重连改为非阻塞检查，测量不再因断网停止
    - 测量移到网络处理之前，重连阻塞只影响当轮周期而不丢采样点
    - MQTT 重连间隔由 5 s 放宽到 15 s
    - 基线下限保护: baseMu < 0.010 g 时拒绝基线，状态上报 uncalibrated
    （实测遇到: 风扇停转时自学习会把噪声底当正常运行水平，导致启动后误报）
    - 串口增加 b 命令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
2026-10-27 feat: 接入 DS18B20 表面温度，形成双通道监测
    新增固件 10_ds18b20_test
    - 器件识别（ROM 地址、分辨率）、连续读数、异常值判据提示
    固件 09_mqtt_telemetry 增加第二通道
    - 引入 OneWire + DallasTemperature，DS18B20 接 GPIO5（模块板载 4.7k 上拉）
    - Record 增加 temp 字段，payload 同时上报 temp（表面温度）与 tchip（芯片温度）
    - 温度越界（<-50 或 >125 ℃）时保留上次有效值
    - 启动打印改为真实检测: mpu.testConnection() 与 ds18b20.getDeviceCount()
    服务端
    - func_split / func_db 优先使用设备上报的 temp 字段，未接入时回退 tchip
    - 仪表板温度卡标签改为"被测体表面温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
2026-10-27 test: 记录 DS18B20 标定与支撑刚度对测量的影响
    新增 experiments/2026-10-27-DS18B20与支撑刚度.md
    DS18B20 温度通道
    - 器件: ROM 28:9C:52:23:7D:25:0B:DD，12 位分辨率，模块板载 4.7k 上拉
    - 稳定性: 读数成段恒定，噪声低于 1 LSB；90 s 内 0.25 ℃ 变化为环境漂移
    - 响应性: 手指捏住 30 s 升温 3.25 ℃，速率单调递减，一阶热响应 tau 约 25~30 s
    - 恢复性: 松手 100 s 降温 4.50 ℃，平滑指数衰减，可逆
    - 设计含义: tau 约 30 s 意味着温度报警须设分钟级确认延时
    支撑刚度实验（重要发现）
    - 现象: 同风扇同转速下振动 RMS 出现 0.055 g 与 0.207 g 两种水平，相差 3.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
2026-10-27 docs: 新增工程报告大纲
    10 章 + 附录，正文约 28~32 页
    章节结构
    1 引言（背景、目标、结构）
    2 需求分析（11 FR / 9 NFR / 13 AC + 验证方法）
    3 方案设计与选型（架构、6 个关键决策的备选对比、信号处理推导）
    4 实现（硬件搭建、固件、服务端、仪表板、成本）
    5 测试与验证（传感器标定、采样验证、工况实验、频谱、联调、AC 符合性矩阵）
    6 数据分析与讨论（灵敏度、亚线性、支撑刚度 3.7 倍、温度时间常数、阈值、偏差、局限）
    7 专业实践（Git、风险、受控文档、调试记录、标准）
    8 负责任的设计（安全、隐私、可持续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
2026-10-27 feat: 接入 microSD 本地存储（连续日志 + 报警波形）
    新增固件 11_sd_test
    - 诊断增强: 自动尝试 1/4/20 MHz 三种 SPI 速度
    - 正常挂载失败后可选格式化（解决 32 GB 卡出厂为 exFAT 的问题）
    - 打印卡类型、容量、写入/读回测试
    固件 09_mqtt_telemetry 接入 SD
    - SPI: CLK=18 MISO=19 MOSI=23 CS=13（VSPI 默认引脚），VCC 必须 5V
    - 每帧追加一行到 /vib_log.csv 并立即 flush（掉电最多丢一条）
    - 报警状态翻转瞬间保存该帧 1024 点原始波形到 /waves/wave_<ts>.csv
    （为事后频谱诊断保留原始数据）
    - SD 挂载失败不影响联网上报（功能降级）
    - 串口命令 l 查看日志大小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
    [09_mqtt_telemetry.ino, 11_sd_test.ino]
2026-10-27 fix: NTP 仅在启动时尝试对时，启动时未联网则永久不对时
    - 烧录后热点恰好未连，setup() 中 syncNTP() 被跳过
    - 之后 WiFi 恢复，但 NTP 不再重试，导致上报的 ts 恒为 0
    - 服务端只能回退到接收时刻，store-and-forward 补发的时间戳失去意义
    - 在 loop 的联网处理段增加 NTP 重试：
    未对时且 WiFi 已连通时，每 60 s 重试一次
    - fix 后验证: ts = 1793106189 -> 2026-10-27 21:03:09，对时正常
    当前运行状态（风扇运转、热点已连）
    - rms 0.1322 g, peak 0.1180 g @ 34.2 Hz
    - temp 24.44 摄氏度（DS18B20 表面）
    - state normal, 阈值 0.1945 / 0.2549 g（自学习）
    - 缓冲 0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
    [09_mqtt_telemetry.ino]
2026-10-28 test: 风道堵塞工况实验 —— 验证温度通道价值与双通道互补性
    实验设计
    - 三组工况: 正常 / 遮挡 50% / 遮挡 80% 进风面
    - 每组遮挡后等待 5 分钟使热状态稳定（tau 约 30 s）
    - 每组采集 21~22 帧
    数据
    工况 温度 ΔT RMS 1x峰值 转频
    ① 正常 24.05 ℃ — 0.0867 g 0.0773 g 34.5 Hz
    ② 50% 24.67 ℃ +0.62 0.0589 g 0.0487 g 34.2 Hz
    ③ 80% 24.85 ℃ +0.80 0.0605 g 0.0242 g 31.5 Hz
    单调性检验（关键）
    - 温度: 单调上升 ✅ 可用于判据
    - 1x 峰值: 单调下降（-69%） ✅ 可用于判据
    - 转频: 单调下降（-8.7%） ✅ 可用于判据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
2026-10-28 docs: 新增实物照片证据与探头位置说明
    新增 evidence/ 照片（6 张，现场手机拍摄，未后期处理）
    - setup_overview.jpg 整体装置
    - mpu6050_mount.jpg 振动传感器安装特写（外框、胶带固定、LED 亮）
    - ds18b20_probe.jpg 温度探头位置（进风面前方、轮毂边缘）
    - wiring_breadboard.jpg 面包板接线全貌，供复现
    - blockage_test.jpg 风道堵塞实验现场
    - device_with_dashboard.jpg 实物与仪表板同框
    新增 evidence/README.md 说明各文件用途与存放位置
    更新 experiments/2026-10-28-风道堵塞工况.md
    - 明确温度探头位置为"进风面前方、电机轮毂边缘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
2026-10-28 feat: 中期答辩 PPT（17 页，四人分讲）
    新增 8.1_振动状态监测器_中期答辩.pptx
    新增 tools/build_ppt.py（可重复生成，便于改内容后重跑）
    结构（按老师要求"四个人都要发言"组织）
    1 封面
    2 汇报分工（四部分与主讲人对照，含时间分配）
    3-4 第一部分 · 成员 A：选题背景、需求规格
    5-7 第二部分 · 成员 B：系统架构、关键选型、信号处理设计
    8-11 第三部分 · 成员 C：硬件实现、固件演进、仪表板、进度对照
    12-16 第四部分 · 成员 D：传感器标定、不平衡实验、堵塞实验、关键发现、下一步
    17 结束页
    设计要点
    - 每张内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
2026-10-28 fix: 移除 PPT 中关于预算与零焊接的表述
    按要求删除与「预算 / 成本 / 零焊接 / 已焊针」相关的全部内容，
    改为中性表述，不改变任何技术数据与实验结论。
    正文改动（8 处）
    - 第 4 页 NFR 卡: 去掉成本与零焊接，改为按类别概括
    - 第 4 页 AC 卡: 去掉成本判据
    - 第 4 页 关键指标: 去掉成本一项，保留采样率误差与报警响应
    - 第 6 页 选型理由: 「成本低、有已焊针版本」改为「I²C 接口简单、资料丰富、量程满足需求」
    - 第 6 页 选型原则: 「零焊接、低门槛」改为「接口简单、资料丰富、易于复现」
    - 第 8 页 标题: 「零焊接的完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
2026-10-29 docs: 新增工程报告（36 页，10 章 + 附录）
    新增 8.1_振动状态监测器_工程报告.docx / .pdf
    新增 build_report.py（主脚本：版式与助手函数）
    新增 report_p1~p4.py（正文分章模块，主脚本按序 exec）
    1 引言：背景、目标与范围、结构
    2 需求分析：11 条 FR、9 条 NFR、13 条 AC 及验证方法、约束与假设
    3 方案设计与选型：三层架构、5 项关键决策对比、采样参数推导、
    带限 RMS 的必要性、特征量定义、判定策略、引脚分配、软件流程
    4 实现：硬件搭建（含实物照片）、11 个固件的演进、服务端、仪表板
    5 测试与验证：传感器标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
2026-10-29 docs: 台账填入实测数据，并统一术语
    6-测试记录（原为空白模板，现为实测结果）
    - 15 条用例，全部通过（P）：采样率、器件身份、重力模长、噪声底、
    FFT 主频、DS18B20 识别/稳定性/响应/恢复、MQTT 上报、断网补发、
    SD 本地记录、报警响应、基线下限保护、仪表板与历史查询
    - 每条均填写测试日期、执行人、实测结果与证据文件路径
    - 移除了与实际方案不符的旧用例（音箱振膜激励、5 g 配重、72 h 运行、
    免焊接检查、成本核算）
    7-工况实验记录（原为空白模板，现为实测结果）
    - 7 组工况：正常基线、不平衡 0.35/0.70 g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
    [8.1_受控文档台账.xlsx]
2026-10-29 chore: 清理台账生成脚本的文档字符串
    [8.1_受控文档台账.xlsx]
2026-10-30 feat(ppt): 新增纯技术版中期答辩 PPT（15 页，四人分讲）
    按"只讲技术、四人各有内容"的要求重做一版，不覆盖已人工修改的 v1。
    新增 8.1_振动状态监测器_中期答辩_技术版.pptx / .pdf
    新增 tools/build_ppt_v2.py
    与 v1 的差别
    - 去掉全部组织性页面：汇报分工、选题背景、进度对照、演示流程、仓库介绍
    - 四部分改为按技术主题划分，每页左上角标注「部分 · 主讲人」
    页面与分工（A 3 页 / B 3 页 / C 3 页 / D 4 页，另封面与结尾）
    2 [A] 监测对象与系统构成
    3 [A] 技术指标：设计判据与实测值（9 项指标表）
    4 [B] 采样参数是怎么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
2026-10-30 feat(ppt): 新增完整版中期答辩 PPT（21 页，仅去掉硬件费用）
    按要求恢复非技术内容，只把「硬件费用」从全篇剔除：
    保留 零焊接、已焊针装配、汇报分工、选题背景、进度对照、现场演示、仓库等表述，
    移除 预算 / 金额 / 成本 / 费用 / ¥ / 价格 / 金额 等费用类表述（逐项检查均为 0）。
    新增 8.1_振动状态监测器_中期答辩_完整版.pptx / .pdf
    新增 tools/build_ppt_v3.py
    页面结构（21 页）
    2 汇报分工与时间分配（4 人 + 演示分工）
    3 [A] 选题背景与课题约束（含零焊接、两路数据要求）
    4 [A] 需求规格：11 FR / 9 NFR / 13 AC
    5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
